LygionOrganization/lygion-wiki/docs/reference/open-lygion/3d3s-chassis.md

# 3D3S 全向底盘

3D3S 全向底盘是一个开源底盘结构项目。目前 Wiki 提供项目 STEP 模型，可用于查看整体结构、评估安装空间并作为后续机械设计的参考。

[下载 STEP 模型](assets/3D3S_Chassis.step){ .md-button }

## 资料

| 文件 | 内容 |
| --- | --- |
| [`3D3S_Chassis.step`](assets/3D3S_Chassis.step) | 3D3S 全向底盘机械结构 STEP 模型 |

## 使用建议

- 先在 CAD 软件中检查模型单位、装配层级和零件干涉。
- 加工或采购零件前，应根据实际硬件复核安装孔、紧固件、线缆空间和运动范围。
- 当前页面不补充未经确认的尺寸、BOM、控制器或负载参数；这些信息应以后续正式发布资料为准。

## 相关入口

- [灵影开源](index.md)
- [下载中心](../../downloads/index.md)
