LygionOrganization/lygion-wiki/docs/reference/index.md

# 产品 Wiki

本章节分别介绍每个产品的具体功能和使用方式。

## 总线设备

| 产品 | 简介 | 推荐入口 |
| --- | --- | --- |
| [RoboCore S3](bus-devices/robocore-s3/index.md) | 用于机器人控制的 ESP32-S3 主控，支持总线设备、网页控制和上位机通信 | [查看文档](bus-devices/robocore-s3/index.md) |
| TTL Adapter (A) | USB / UART 转单线 TTL 总线通信适配器 | [查看文档](bus-devices/ttl-adapter-a/index.md) |
| TTL Encoder E02 | 12bit 360° 绝对角度磁编码器 | [查看文档](bus-devices/ttl-encoder-e02/index.md) |
| TTL Stepper Driver (A) | 单线 TTL 总线步进电机驱动板 | [查看文档](bus-devices/ttl-stepper-driver-a/index.md) |

## Hub 分线板

- [TTL-5264 8P Hub (A)](../reference/bus-devices/hub-boards/ttl-5264-8p-hub-a.md)
- [HC-1.25 8P Hub (A)](../reference/bus-devices/hub-boards/hc-1.25-8p-hub-a.md)

## 建议阅读方式

- 第一次使用：先看 [快速开始](../quickstart/index.md)。
- 遇到基础问题：先看 [基础教程](../tutorials/index.md)。
- 需要产品参数、接线、SDK 和 FAQ：进入对应产品参考页。
