LygionOrganization/lygion-wiki/docs/downloads/index.md

# 下载中心

本页集中放置 Lygion Wiki 中常用的软件、SDK、模型和资料链接。选择对应产品即可下载图片、CAD 模型和示例程序。

## SDK 与软件

| 类型 | GitHub / 官网 | 本站下载 | 相关教程 |
| --- | --- | --- | --- |
| Python SDK | [lygion_devs_py](https://github.com/LygionOrganization/lygion_devs_py) | [lygion_devs_py.zip](../assets/files/lygion_devs_py.zip) | [Python 快速上手](../quickstart/python-first-demo.md) |
| C++ / Arduino SDK | [lygion_devs_cpp](https://github.com/LygionOrganization/lygion_devs_cpp) | [lygion_devs_cpp.zip](../assets/files/lygion_devs_cpp.zip) | [C++ / Arduino 快速上手](../quickstart/cpp-first-demo.md) |
| FD 调试软件 | - | [FD.7z](../assets/files/FD.7z) | [FD 调试软件教程](../tutorials/fd-tool.md) |

## 总线设备模型

| 产品 | CAD / 模型 |
| --- | --- |
| TTL Adapter (A) | [ttl-adapter-a.step](../reference/bus-devices/ttl-adapter-a/assets/ttl-adapter-a.step) |
| TTL Encoder E02 | [TTL-Encoder-E02.step](../reference/bus-devices/ttl-encoder-e02/assets/TTL-Encoder-E02.step) |
| TTL Stepper Driver (A) | [TTL Stepper Driver STEP](../reference/bus-devices/ttl-stepper-driver-a/assets/TTL_SD_Simple%20Assembly.step) |
| Robot Driver with ESP32S3 Lite | [Robot Driver with ESP32S3 Lite.step](<../reference/bus-devices/robot-driver-with-esp32s3-lite/assets/Robot Driver with ESP32S3 Lite.step>) |
| SC-0090-C043 总线舵机 | [SC-0090-C043.step](../reference/bus-devices/bus-servos/assets/SC-0090-C043.step) |
| SC-0090-C049 总线舵机 | [SC-0090-C049.step](../reference/bus-devices/bus-servos/assets/SC-0090-C049.step) |
| SC-1500-C023 总线舵机 | [SC-1500-C023.step](../reference/bus-devices/bus-servos/assets/SC-1500-C023.step) |
| SC-1500-C024 总线舵机 | [SC-1500-C024.stp](../reference/bus-devices/bus-servos/assets/SC-1500-C024.stp) |
| 0090 系列舵盘 | [圆形](../reference/bus-devices/bus-servos/assets/arms-0090/cycle.stp) · [半臂](../reference/bus-devices/bus-servos/assets/arms-0090/haftarm.stp) · [单臂](../reference/bus-devices/bus-servos/assets/arms-0090/onearm.stp) · [十字](../reference/bus-devices/bus-servos/assets/arms-0090/tenarm.stp) |

## 机器人模组模型

| 产品 | CAD / 模型 |
| --- | --- |
| 舵轮 SW69-TTL | [SW69-TTL_STEP.step](../reference/modules/sw69-ttl/assets/SW69-TTL_STEP.step) |
| 步进电机 4240BY-G5.2 | [4240BY-G5.2.step](../reference/modules/4240by-g5-2/assets/4240BY-G5.2.step) |
| 驱动轮 DW69 | [DW69 [SP01].step](<../reference/modules/dw69/assets/DW69 [SP01].step>) · [DW69 [SP02][SP03].step](<../reference/modules/dw69/assets/DW69 [SP02][SP03].step>) |
| 关节执行器 DM42-G7220-E02 | [DW42-G7220-E02.step](../reference/modules/dm42-g7220-e02/assets/DW42-G7220-E02.step) |
| 同步轮 3M 72T | [SP3M72-E02.step](../reference/modules/pulley-3m-72t/assets/SP3M72-E02.step) |

## 开源项目模型

| 项目 | 文件 |
| --- | --- |
| 3D3S 全向底盘 | [3D3S_Chassis.step](../reference/open-lygion/assets/3D3S_Chassis.step) |
| 6x6 Rover | [6x6-rover.zip](../reference/open-lygion/assets/6x6-rover.zip) |
| 5+1 DOF Robotic Arm | [5-plus-1-dof-robotic-arm.step](../reference/open-lygion/assets/5-plus-1-dof-robotic-arm.step) |
| Open Leader Arm | [open_leader_arm.step](../reference/open-lygion/assets/open_leader_arm.step) |
| Self-locking Gripper | [self-locking-gripper.step](../reference/open-lygion/assets/self-locking-gripper.step) |
| OpenLygion 4WD AL | [OpenLygion 4WD AL.step](<../reference/open-lygion/assets/OpenLygion 4WD AL.step>) |
| OpenLygion 4WD SheetMetal | [OpenLygion 4WD SheetMetal.step](<../reference/open-lygion/assets/OpenLygion 4WD SheetMetal.step>) |
| OpenLygion Balance | [OpenLygion Balance.step](<../reference/open-lygion/assets/OpenLygion Balance.step>) |

## 常用入口

- [总线设备](../reference/bus-devices/index.md)
- [机器人整机](../reference/robots/index.md)
- [灵影开源](../reference/open-lygion/index.md)
- [基础教程](../tutorials/index.md)
