LygionOrganization/lygion-wiki/docs/reference/open-lygion/index.md

# 灵影开源

这里收录 Lygion 公开的 SDK、示例工程和机械结构资料。代码以 GitHub 组织内的仓库为准，本站页面主要提供快速入口和本地素材下载。

[LygionOrganization on GitHub](https://github.com/LygionOrganization/){ .md-button }

## SDK

| 页面 | 用途 |
| --- | --- |
| [Python SDK](python-sdk.md) | 在电脑、树莓派、Jetson 等上位机环境中调试和控制 Lygion TTL 总线设备。 |
| [C++ SDK](cpp-sdk.md) | 在 ESP32、Arduino、STM32 Arduino Core、PlatformIO 等嵌入式环境中控制 Lygion TTL 总线设备。 |

## 开源项目

| 项目 | 资料 |
| --- | --- |
| [3D3S 全向底盘](3d3s-chassis.md) | 全向底盘结构项目，提供 STEP 模型。 |
| [6x6 Rover](6x6-rover.md) | 六轮移动底盘，提供项目图片和压缩模型资料。 |
| [5+1 DOF Robotic Arm](5-plus-1-dof-robotic-arm.md) | 5+1 自由度机械臂，提供 STEP 模型。 |
| [Open Leader Arm](open-leader-arm.md) | 开源机械臂结构项目，提供 STEP 模型。 |
| [Self-locking Gripper](self-locking-gripper.md) | 自锁夹爪机构，提供 STEP 模型。 |

!!! tip "第一次使用建议"
    如果你还不熟悉串口、设备 ID、波特率和供电方式，建议先阅读[基础教程](../../tutorials/index.md)，再运行 SDK 示例。
