LygionOrganization/lygion-wiki/docs/reference/open-lygion/open-leader-arm.md

# Open Leader Arm

Open Leader Arm 是一个开源机械臂结构项目。目前 Wiki 提供项目 STEP 模型，可用于查看机械结构、评估安装关系并作为后续设计与装配验证的参考。

[下载 STEP 模型](assets/open_leader_arm.step){ .md-button }

## 资料

| 文件 | 内容 |
| --- | --- |
| [`open_leader_arm.step`](assets/open_leader_arm.step) | Open Leader Arm 机械结构 STEP 模型 |

## 使用建议

- 先在 CAD 软件中确认模型单位、装配层级、关节关系和零件干涉。
- 制作实物前，应根据拟使用的执行器、轴承、紧固件和线缆重新核对安装关系。
- 当前页面不补充未经确认的自由度、行程、负载、BOM 或控制方案；这些信息应以后续正式发布资料为准。

## 相关入口

- [灵影开源](index.md)
- [下载中心](../../downloads/index.md)
