LygionOrganization/lygion-wiki/docs/reference/modules/index.md

# 机器人模组

本分类收录 Lygion 机器人项目中常用的机械、电机、轮组和执行器模组。每个产品页面提供产品概览、典型应用、集成建议和机械资料下载入口。

| 模组 | 简介 | 入口 |
| --- | --- | --- |
| 舵轮 SW69-TTL | 集成转向、行走驱动、编码器反馈和 TTL 总线控制能力的舵轮模组。 | [查看页面](sw69-ttl/index.md) |
| 步进电机 4240BY-G5.2 | 带减速机构的 42 系列双极步进电机，可配合步进驱动器实现位置或速度控制。 | [查看页面](4240by-g5-2/index.md) |
| 同步轮 3M 72T | 72 齿 3M 同步轮，适合机器人关节、转台和同步带传动结构。 | [查看页面](pulley-3m-72t/index.md) |
| 驱动轮 DW69 | 69 mm 级机器人底盘驱动轮组件，适合移动平台和自定义轮式机构。 | [查看页面](dw69/index.md) |
| 关节执行器 DM42-G7220-E02 | 集成步进电机、同步带传动和编码器安装结构的机器人关节执行器。 | [查看页面](dm42-g7220-e02/index.md) |

## 相关分类

- [总线设备](../bus-devices/index.md)
- [机器人整机](../robots/index.md)
