LygionOrganization/lygion-wiki/docs/reference/open-lygion/5-plus-1-dof-robotic-arm.md

# 5+1 DOF Robotic Arm

5+1 DOF Robotic Arm 是一个 5+1 自由度机械臂结构项目。本站目前提供项目 STEP 模型。

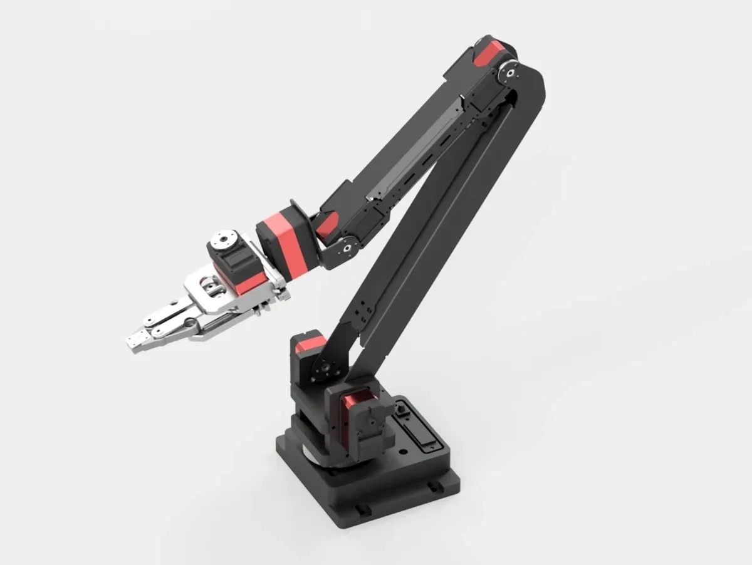
[picture p17: docs/reference/open-lygion/assets/5-plus-1-dof-robotic-arm.webp]
5+1 DOF Robotic Arm


[下载 STEP 模型](assets/5-plus-1-dof-robotic-arm.step){ .md-button }

## 资料

| 文件 | 说明 |
| --- | --- |
| [`5-plus-1-dof-robotic-arm.step`](assets/5-plus-1-dof-robotic-arm.step) | 机械结构 STEP 模型 |

## 使用建议

- STEP 文件可用于结构查看、装配参考和二次设计。
- 上电调试前，请先确认各关节零位、运动范围和线缆余量。
- 控制程序可参考 [Python SDK](python-sdk.md) 或 [C++ SDK](cpp-sdk.md)。
