LygionOrganization/lygion-wiki/docs/en/reference/open-lygion/index.md

# Open Lygion

This section collects public Lygion SDKs, example projects, and mechanical resources. Source code should be treated as authoritative on GitHub; the Wiki provides quick entry points and local downloads for commonly used assets.

[LygionOrganization on GitHub](https://github.com/LygionOrganization/){ .md-button }

## SDKs

| Page | Use case |
| --- | --- |
| [Python SDK](python-sdk.md) | Develop and debug Lygion TTL bus devices from PCs, Raspberry Pi, Jetson, and other host platforms. |
| [C++ SDK](cpp-sdk.md) | Control Lygion TTL bus devices from ESP32, Arduino, STM32 Arduino Core, PlatformIO, and similar embedded environments. |

## Open Projects

| Project | Resource |
| --- | --- |
| [3D3S Omnidirectional Chassis](3d3s-chassis.md) | Omnidirectional chassis structure with a downloadable STEP model. |
| [6x6 Rover](6x6-rover.md) | Six-wheel mobile platform with downloadable model package. |
| [5+1 DOF Robotic Arm](5-plus-1-dof-robotic-arm.md) | 5+1 DOF robotic arm structure with STEP model. |
| [Open Leader Arm](open-leader-arm.md) | Open robotic-arm structure with a downloadable STEP model. |
| [Self-locking Gripper](self-locking-gripper.md) | Self-locking end-effector mechanism with STEP model. |

!!! tip "Start with the fundamentals"
    If serial ports, device IDs, baud rates, and power wiring are new to you, read the [tutorials](../../tutorials/index.md) before running SDK examples.
