LygionOrganization/lygion-wiki/docs/en/reference/modules/index.md

# Robot Modules

This section covers Lygion mechanical modules, drive modules, and joint modules that are commonly used in mobile robots, teaching platforms, and experimental mechanisms.

| Module | What it is for | Page |
| --- | --- | --- |
| SW69-TTL Steering Wheel Module | A compact steering-and-drive wheel module for omnidirectional mobile robot bases. | [Open page](sw69-ttl/index.md) |
| 4240BY-G5.2 Stepper Motor | A geared 42 mm stepper motor for low-speed, higher-torque robot mechanisms. | [Open page](4240by-g5-2/index.md) |
| DW69 Drive Wheel | A 69 mm drive wheel assembly for small mobile robot chassis. | [Open page](dw69/index.md) |
| DM42-G7220-E02 Joint Actuator | A belt-driven stepper joint with output-side encoder feedback. | [Open page](dm42-g7220-e02/index.md) |
| 3M 72T Timing Pulley | A 72-tooth 3M timing pulley for belt-driven joints and rotary mechanisms. | [Open page](pulley-3m-72t/index.md) |

## Related Documentation

- [TTL Bus Devices](../bus-devices/index.md)
- [Downloads](../../downloads/index.md)
- [Quick Start](../../quickstart/index.md)
