LygionOrganization/lygion-wiki/docs/reference/modules/pulley-3m-72t/index.md

# 同步轮 3M 72T

同步轮 3M 72T 是一款用于 3M 齿形同步带传动的 72 齿同步轮。该产品适合用于机器人关节、转台、轮组、滑台和其它需要同步带传动的机械结构。

## 产品特点

- 3M 齿形规格，适配 3M 同步带。
- 72 齿设计，适合构建较大直径输出端或减速传动结构。
- 提供 E02 编码器安装相关结构，适合需要角度反馈的输出轴应用。
- 提供 PDF、DXF 和 STEP 资料，便于结构设计和加工核对。

## 典型应用

- 机器人关节输出端同步轮
- 转台或摆臂机构
- 同步带减速结构
- 需要在输出端读取角度的传动机构

## 机械接口

下表列出当前图纸中可快速识别的主要机械信息。正式设计时请以 PDF、DXF 或 STEP 文件为准。

| 项目 | 参数 |
| --- | --- |
| 同步带规格 | 3M |
| 齿数 | 72T |
| 编码器安装孔 | 8 × M3 × 0.5 |
| 编码器安装孔分布圆 | Ø60 |
| 辅助安装孔 | 6 × M4 × 0.7 通孔 |
| 中心参考孔径 | Ø23 |

!!! note "图纸优先"
    同步轮会直接影响同步带啮合、中心距和输出端同轴度。设计中心距、皮带长度和安装孔位时，请以机械图纸和 3D 模型为准。

## 与编码器配合

若需要读取同步轮或输出轴角度，可将同步轮结构与 [TTL Encoder E02](../../bus-devices/ttl-encoder-e02/index.md) 配合使用。编码器通过检测磁铁角度输出绝对位置，适用于关节角度读取、输出端校准和上电位置恢复等场景。

使用编码器时需要注意：

- 磁铁中心应尽量对准编码器 IC 中心。
- 磁铁与编码器 IC 上表面的距离应符合编码器安装要求。
- 编码器 PCB 应固定可靠，避免运行时松动。
- 编码器 ID 应与同一 TTL 总线上的其它设备保持唯一。

## 设计建议

1. 根据同步带规格、齿数和中心距计算合适的皮带长度。
2. 输出端负载较大时，应检查同步带张力、轴承支撑和安装板刚性。
3. 若作为关节输出端，应预留编码器线缆和维护空间。
4. 加工前请使用 STEP 模型检查同步轮、轴承、支架和相邻零件之间的干涉。

## 资料下载

| 资料 | 文件 |
| --- | --- |
| STEP 3D 模型 | [SP3M72-E02.step](assets/SP3M72-E02.step) |
| 机械图纸 PDF | [SP3M72-E02.pdf](assets/SP3M72-E02.pdf) |
| DXF 图纸 | [SP3M72-E02.dxf](assets/SP3M72-E02.dxf) |

## 相关资料

- [TTL Encoder E02](../../bus-devices/ttl-encoder-e02/index.md)
- [TTL Encoder E02：硬件安装](../../bus-devices/ttl-encoder-e02/hardware-installation.md)
- [机器人模组](../index.md)
