LygionOrganization/lygion-wiki/docs/en/reference/open-lygion/6x6-rover.md

# 6x6 Rover

6x6 Rover is an open six-wheel mobile platform project. The current Wiki page provides the project image and downloadable model package. The model package can be used as the starting point for 3D-printed builds or mechanical review.

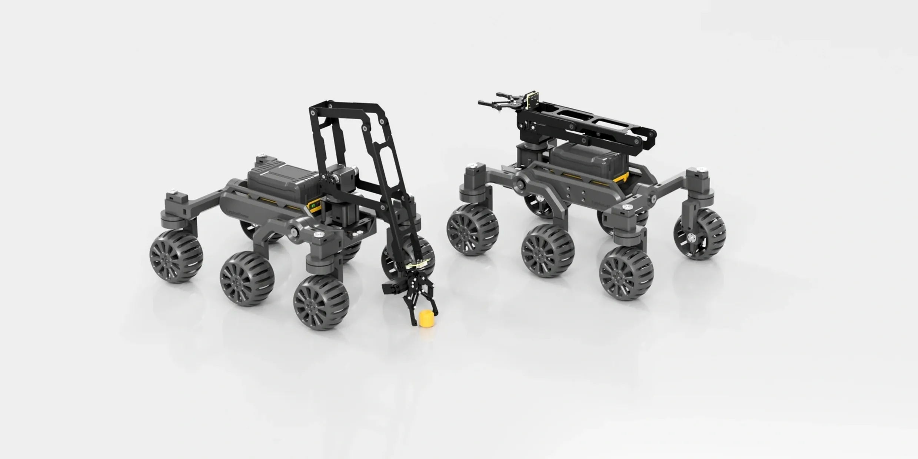
[picture p70: docs/reference/open-lygion/assets/6x6-rover.webp]
6x6 Rover


[Download Model Package](../../../reference/open-lygion/assets/6x6-rover.zip){ .md-button }

## Resources

| File | Description |
| --- | --- |
| [`6x6-rover.zip`](../../../reference/open-lygion/assets/6x6-rover.zip) | Mechanical model / project resource package |

## Notes

- Extract the ZIP package before opening the model files.
- Before redesigning the platform, check the space needed for the battery, controller, servos, motors, and wiring.
- For control software, see the [Python SDK](python-sdk.md), [C++ SDK](cpp-sdk.md), and [TTL bus tutorials](../../tutorials/index.md).
