LygionOrganization/lygion-wiki/docs/en/reference/bus-devices/bus-servos/sc-1500-c023.md

# SC-1500-C023 Dual-Shaft TTL Bus Servo

SC-1500-C023 is a 15kg.cm class dual-shaft TTL serial bus servo. Its specification model is `SCS15-C023`. It uses a plastic housing, cored motor, brass gears, and ball bearings, making it suitable for medium-load joints, dual-supported linkages, mobile robot mechanisms, and educational platforms.

SC-1500-C023

[Download 3D Model](../../../../reference/bus-devices/bus-servos/assets/SC-1500-C023.step){ .md-button download }

## Key Specifications

| Item | Value |
| --- | --- |
| Specification model | `SCS15-C023` |
| Output structure | Dual shaft |
| Operating voltage | DC 9-12.6V |
| Recommended supply | 3S lithium battery pack or DC supply up to 12.6V |
| No-load speed | 0.167sec/60deg, about 60RPM |
| No-load current | 240mA |
| Stall torque | 15.6kg.cm |
| Stall current | 2.5A |
| Static current | 40mA |
| Rated load | 5kg.cm, about 1/3 of stall torque |
| Rated current | 800mA |
| Kt constant | 6.5kg.cm/A |
| Operating temperature | -10 to 60degC |
| Storage temperature | -30 to 80degC |

## Mechanical Data

| Item | Value |
| --- | --- |
| Dimensions | 40.2 x 20.2 x 40mm |
| Weight | 58.2 +/- 1g |
| Housing | PA |
| Gears | Brass |
| Bearing | Ball bearing |
| Angle sensor | Carbon-film potentiometer |
| Connector | PH2.0-3P |
| Cable length | 15cm |
| Output spline | 25T / OD 5.9mm |
| Gear ratio | 1/275 |
| Backlash | <=0.5deg |
| Output screw | M3 x 6 |
| Motor | Cored motor |

## 3D Model

- [Servo body STEP](../../../../reference/bus-devices/bus-servos/assets/SC-1500-C023.step){ download }

## Connector and Pinout

| Pin | Definition |
| --- | --- |
| 1 | GND |
| 2 | Vcc |
| 3 | Signal / TTL |

!!! warning "Check the connector before wiring"
    This model uses a PH2.0-3P connector. Follow the pinout for this model and do not mix it with other connector families.

## Control Characteristics

| Item | Value |
| --- | --- |
| Control signal | Digital packet |
| Protocol | Half-duplex asynchronous serial, 8 data bits, 1 stop bit, no parity |
| ID range | 0-253, factory default ID 1 |
| Baud rate | 38400bps-500000bps, factory default 500000bps |
| Control algorithm | PID, configurable |
| Center position | 511 |
| Controllable angle | 210 +/- 5deg, position range 0-1023 |
| Electronic resolution | 0.215deg/pulse, 220deg/1024 |
| Default direction | Clockwise, 0 to 1023, configurable |
| Feedback | Load, position, operating speed, input voltage, temperature |
| Operating modes | Mode 0: position servo mode; Mode 2: open-loop speed motor mode |

## Motion Characteristics

SC-1500-C023 Motion Characteristics

## Protection and Reliability

- Overload protection: triggers after load exceeds 80% of stall torque for 4s. Send a new position command to clear the overload flag.
- Over-voltage / under-voltage protection: triggers above 12.6V or below 9V, and clears automatically once voltage returns to range.
- Over-temperature protection: disables torque output above 70degC.
- Maximum position update rate: 1ms.
- Logic high: 2-5V.
- Logic low: 0-0.45V.
- Load life test: more than 50,000 cycles.
- Waterproofing: not waterproof.

## Getting Started

- [Power and Wiring](../../../tutorials/power-and-wiring-basics.md)
- [Power Grouping and Isolation](../../../tutorials/power-grouping-and-decoupling.md)
- [Device IDs and Baud Rates](../../../tutorials/device-id-and-baudrate.md)
- [FD Device Utility](../../../tutorials/fd-tool.md)
- [Find the Serial Port](../../../tutorials/find-serial-port.md)
- [Communication Troubleshooting](../../../tutorials/communication-troubleshooting.md)

!!! danger "Plan for peak current"
    A 15kg.cm class servo can draw high peak current during startup or stall. Size the power supply, switch, wiring, and hub for peak current, not only average load.
