LygionOrganization/lygion-wiki/docs/en/reference/bus-devices/hub-boards/hc-1.25-8p-hub-a.md

# HC-1.25 8P Hub (A)

HC-1.25 8P Hub (A) fans out one TTL bus into eight compact HC-1.25-3P connectors. It is intended for small robots, dexterous hands, legged robots, and other space-constrained modular systems.

[Power grouping and isolation guide](../../../tutorials/power-grouping-and-decoupling.md){ .md-button }

## Features

- Eight HC-1.25-3P device connectors
- HX-5264-3P connection for TTL Adapter (A) or a compatible controller
- GH-1.25-3P communication-only connection for cascading or power isolation
- Power indicator
- Approximate size: `39 x 21 mm`
- Four mounting holes, approximately 2.6 mm diameter

## Interfaces

| No. | Interface | Purpose |
| --- | --- | --- |
| 1 | HX-5264-3P | Communication and power connection to TTL Adapter (A) or a compatible controller |
| 2 | Eight HC-1.25-3P connectors | Connect compact TTL bus devices |
| 3 | Power indicator | Shows whether power is present |
| 4 | GH-1.25-3P | Communication-only connection to an adapter or another hub |
| 5 | Mounting holes | Four holes, approximately 2.6 mm diameter |

!!! warning "GH-1.25-3P is for communication only"
    Power devices through a connector or input explicitly designed to carry power.
