LygionOrganization/lygion-wiki/docs/reference/bus-devices/robocore-s3/json-api.md

# RoboCore S3 JSON 接口

RoboCore S3 完整固件使用人类可读的 JSON 指令控制设备。下文按用途列出指令、参数与发送示例。

## 通信方式

- **WebSocket**：`ws://192.168.4.1/ws`，每帧发送一个完整 JSON 文本；执行结果广播到已连接客户端。
- **HTTP**：`POST /api/cmd`，`Content-Type: application/json`。返回 `202 {"accepted":true,"policy":"latest-wins"}` 仅表示已接收；使用 `GET /api/result` 读取最新执行结果，按 `rid` 匹配。不是同步执行接口，不会返回历史结果。
- **USB CDC**：原生 USB 端口，每条 UTF-8 JSON 后发送 `\n`。持续读取换行分隔的回复；日志与 JSON 可能混合，忽略非 JSON 行。默认启用 USB 输出；若 `T=604` 关闭了 USB 输出，就无法从该端口读取结果。
- **ESP-NOW**：沿用原有 250 字节、零填充 JSON 消息帧，接收模式、可信 MAC 与信道按 `T=410…414` 配置。该传输不自动返回执行结果。

命令最大 255 字节（UTF-8 编码，不计换行）。HTTP/WebSocket 使用单个完整请求体/文本帧；分片或超长数据拒绝。JSON 必须有整数 `T`。可加入 `rid`（0…4294967295 整数）；执行结果原样返回，客户端同时最多等待一条命令，建议随机起始并递增，避免多客户端碰撞。

**最新命令优先**：当前命令不被抢占，仅保留最新的一条待执行指令。运行 1 时收到 2、3，之后执行 3。HTTP、WebSocket、USB、ESP-NOW 等共用这一队列。不保证每条指令执行，也不自动重试 EEPROM 写入。配置流程应逐条发出并等待对应结果，超时先读取状态再决定是否重试。

`{"T":0}` 在接收时设置退出循环标志、清空待执行命令，不入队，也没有结构化的执行回复。它会在循环检查点生效，不等于电机急停。连续速度用 `T=725,speed=0` 停止，关闭步进输出用 `T=726,enable=0`。永久任务占住执行器时，普通指令等待；先停止任务再执行调试命令。

自动化脚本的编辑、保存和运行见 [网页自动化脚本](automation.md)。

## 通用参数与使用顺序

JSON 的字段名区分大小写。表格中的示例是完整对象；按实际设备修改 ID、位置和速度后再发送。除明确标为可选的参数外，请填写示例中的全部字段。舵机与机械臂指令的参数范围因型号和机构而异，发送前应核对目标设备及机械行程。同步接口会校验数组长度、ID唯一性、位置范围与数值类型；SCS位置0–1023，其他同步位置0–4095。

| 字段 | 含义与单位 |
| --- | --- |
| `id` / `old_id` / `new_id` | 当前、原、新设备 ID。普通控制使用实际单个 ID；254 为部分旧协议的广播地址，读取/改 ID 不使用广播 |
| `baud` | 主控 UART 总线比特率，必须与设备一致；推荐优先使用 T=10，重启后按启动配置恢复 |
| `pos` | 舵机位置计数；SCS 常见范围 0–1023，STS/SMS/HLS 常见 0–4095，最终以具体型号及限位为准 |
| `spd` / `acc` | 舵机速度/加速度寄存器值。不是所有型号都接受 0，0 也不一定表示停止；HLS 使用非零速度 |
| `time` | SCS 运动时间，毫秒；与速度的优先关系按舵机协议。不要用 time=0、spd=0 作为停止命令 |
| `state` | 舵机扭矩：0 释放，1 使能；释放前支撑负载 |
| `cl` / `tor` | HLS 单轴电流限制 / 同步控制中每轴限制数组，寄存器值，不直接表示安培 |
| `idn` | 同步控制的设备数；所有数组长度均应等于 idn，范围1–16，不能超过连接设备数量；完整命令也必须能装入255字节 |
| `id[] / pos[] / spd[] / acc[] / tor[]` | 同索引属于同一轴。简化同步命令省略速度/加速度字段，并不提供与完整同步命令相同的控制选项 |
| `mid` / `ang` / `rad` | SCS 角度控制的参考计数 / 目标角度（度）/ 目标弧度，依赖 T=102 的换算设置；这两种指令的 spd 分别为度/秒、弧度/秒 |
| `move` | T=109/112/115：1 立即下发运动，0 预置寄存器动作，再用 T=118 触发 |
| `steps` / `angle` | T=102：每圈计数至少512、行程角度90–360°，用于舵机坐标换算 |
| `set` | T=200 为 `[灯序号,r,g,b]`，T=201 为 `[r,g,b]`；针对兼容旧灯控制器，不是 T=712 的色值规范 |
| `line` / `text` / `update` | OLED 行号1–4、ASCII文本、是否刷新（0暂存/1刷新）；T=203 刷新，T=204 的 l1…l4 一起更新 |
| `num` | 旧 Node 接口的灯数量/刷新范围，按对应设备协议；Node 控制优先 T=712 |
| `freq` / `duration` | 蜂鸣器频率Hz、持续毫秒；duration=0 不表示持续鸣叫 |
| `ang[] / rad[] / pos[]` | 机械臂四关节角度、弧度、零位计数数组；顺序为底座、肩、肘、夹爪 |
| `xyzg` | 机械臂 `[x,y,z,g]`，位置为mm、夹爪角度为度；工作空间取决于匹配的机械臂结构 |
| `rbzg` | 机械臂 `[r,b,z,g]`，r/z为mm、底座角b和夹爪角g为度 |
| `spd` / `br`（机械臂） | 平滑运动参数、底座插值比例；不是舵机原始 spd 单位，请使用匹配机械臂的配置 |
| `flag` / `hz` | T=145：周期反馈开关0/1、反馈频率；不会替换 T=740 的板载惯性传感器读取 |
| `flag` / `axis` / `delta` | T=146：连续运动开关0/1、预设坐标轴、每次增量；仅适用于匹配的机械臂应用 |

先用 T=700 扫描，再用对应反馈指令读取设备，最后测试低速、限位内的动作。同一组 IO4/IO5 的 TTL 与总线设备 RS485 共用波特率和数据，不能当作独立串口。外部 CAN/RS485 在 IO13/IO14，由开关与运行程序共同决定通信功能。

### 同步舵机示例

两只 STS/SMS 舵机应有不同 ID，并支持目标位置。先分别读取 T=15，再发送：

```json
{"T":16,"id":[1,2],"idn":2,"pos":[2047,2100],"spd":[100,100],"acc":[10,10]}
```

若只是要读取板子本身的运动数据，使用 `{"T":740}`；它读取板载 QMI8658A，不是外接 TTL IMU。

## 发送与接收示例

以下接收内容是示意，实际 ID 和读数以设备为准。HTTP 使用 GET /api/result 获取接收结果；WebSocket 直接接收推送。

| 操作 | 发送 | 接收示例 |
| --- | --- | --- |
| 扫描设备 | `{"T":700,"first":0,"last":20,"rid":1}` | `{"T":700,"rid":1,"ok":true,"ids":[1,5],"first":0,"last":20}` |
| 读取编码器 | `{"T":732,"id":1,"rid":2}` | `{"T":732,"rid":2,"id":1,"ok":true,"bus_error":0,"reply_status":0,"pos":2048,"speed":0}` |
| IMU 不可用 | `{"T":740,"rid":3}` | `{"T":740,"rid":3,"ok":false,"present":false,"error":"imu_not_present"}` |

`ok:false` 表示参数或设备通信失败。部分指令返回 `dispatched:true`，只表示处理器已完成分发，不代表电机动作成功。设备 ID 设置 T=13/23/33/710/720 会检查新 ID；编码器与步进驱动共用 T=720。

## 只读端点

| 端点 | 内容 |
| --- | --- |
| GET /api/info | 固件、总线波特率、IMU、任务状态，以及 sta_state、sta_ip、ap_ip、sta_ssid；无密码 |
| GET /api/result | 最新一条执行结果，通过 rid 匹配；不保存历史 |
| GET /api/imu | 板载 IMU 最新有效快照；只读，不进入指令队列，字段见下文 |

## IMU 反馈（T=740 / GET /api/imu）

`GET /api/imu` 直接返回只读快照，不进入指令队列。单次指令发送 `{"T":740,"rid":1}`，成功接收格式如下（数值仅为示例）：

```json
{"T":740,"rid":1,"ok":true,"present":true,"address":106,"sample_age_ms":2,"sample_count":123,"temperature_c":25.0,"accel_g":[0,0,1],"gyro_dps":[0,0,0]}
```

| 字段 | 含义 |
| --- | --- |
| `present` / `address` | 是否检测到传感器 / 十进制 I2C 地址 |
| `accel_g` / `gyro_dps` | X、Y、Z 轴加速度（g）/ 角速度（度/秒）|
| `temperature_c` | 传感器温度（℃）|
| `sample_count` | 24 位循环样本计数；相同计数表示同一份样本 |
| `sample_age_ms` | 缓存样本距今的毫秒数；无有效样本为 -1 |
| `ok` / `error` | 仅在 ok=true 时使用测量值；超过 100 ms 的旧样本返回 imu_no_fresh_sample |

实时读取应逐次等待响应，建议每秒约 10 次或更低，不保存请求历史。网页估算横滚、俯仰和相对航向；六轴 IMU 不提供绝对航向。

T=723/732 的 reply_status 表示位置和速度读取回复中的合并状态标志。T=723 的 device_status 来自实际驱动状态寄存器，device_fault、current_limited、limit_active、target_out_of_range 分别表示故障、限流、限位和目标越界；限流不等于故障。

<!-- COMMAND_TABLES -->

## 通信与系统

| T | 功能 | 发送 JSON | 参数说明 |
| --- | --- | --- | --- |
| 0 | 停止任务循环 | `{"T":0}` | 请求退出任务循环、清空待执行指令；不会关闭电机输出。 |
| 51 | 等待毫秒数 | `{"T":51,"delay":1000}` | delay：等待时间，毫秒；任务中使用可控制步骤节奏。 |
| 180 | 四路轮毂电机速度 | `{"T":180,"A":0,"B":0,"C":0,"D":0}` | A/B/C/D 为匹配的四路轮毂电机速度，寄存器值 × 0.06 = rpm；不是通用步进控制。 |
| 399 | 清空文件系统 | `{"T":399}` | 清空全部任务及文件系统内配置；不自动重启，无法撤销。 |
| 400 | 设置 Wi-Fi | `{"T":400,"mode":1,"ap_ssid":"LYgion","ap_password":"12345678","channel":1,"sta_ssid":"ssid","sta_password":"password"}` | mode=0 关闭 Wi-Fi，1 开启 AP+STA。STA 后台连接，失败仍保留配置；GET /api/info 查询状态和 IP。路由器须支持 2.4 GHz。 |
| 401 | 读取 Wi-Fi 配置 | `{"T":401}` | 按示例字段设置参数；执行前确认目标设备和供电。 |
| 402 | 读取热点 IP | `{"T":402}` | 按示例字段设置参数；执行前确认目标设备和供电。 |
| 403 | 读取路由器分配的 IP | `{"T":403}` | 按示例字段设置参数；执行前确认目标设备和供电。 |
| 410 | 初始化 ESP-NOW | `{"T":410,"longrange":0}` | longrange：0 普通模式，1 长距离模式；双方需支持并使用兼容模式、同一信道。 |
| 411 | 设置 ESP-NOW 接收模式 | `{"T":411,"mode":1}` | mode：0 关闭接收，1 接收可信 MAC，2 接收广播。 |
| 412 | 读取 MAC 地址 | `{"T":412}` | 按示例字段设置参数；执行前确认目标设备和供电。 |
| 413 | 发送 ESP-NOW JSON | `{"T":413,"mac":"FF:FF:FF:FF:FF:FF","data":"{\"T\":205}"}` | mac 为冒号分隔的 MAC；data 为转义的 JSON 字符串。使用 250 字节补零帧，不能任意发送大对象。 |
| 414 | 添加 ESP-NOW 对端 | `{"T":414,"mac":"FF:FF:FF:FF:FF:FF"}` | mac 为对端 MAC 地址；先确认双方 Wi-Fi 信道相同。 |
| 415 | ESP-NOW 模拟 MAC 开关 | `{"T":415,"fake":0}` | fake 为兼容应用的模拟 MAC 开关；常规通信保持 0。 |
| 501 | 发送 CAN 帧 | `{"T":501,"id":291,"ext":0,"data":[17,34,51]}` | CAN 档；id 为标识符，ext=0 标准帧/1 扩展帧，data 最多 8 个 0–255 字节；默认 500 kbps。 |
| 600 | 重启主控 | `{"T":600}` | 立即重启，连接中断；可能无法收到执行回复。 |
| 601 | 清空 NVS | `{"T":601}` | 清空 NVS 设置；与任务文件系统不同。此操作不可撤销。 |
| 602 | 清空文件系统 | `{"T":602}` | 清空全部任务及文件系统内配置；不自动重启，无法撤销。 |
| 603 | 读取消息输出设置 | `{"T":603}` | 按示例字段设置参数；执行前确认目标设备和供电。 |
| 604 | 设置消息输出 | `{"T":604,"echo":1,"uart":0,"usb":1}` | echo/uart/usb 为 0 或 1；关闭 usb 后 USB 不再输出结果。 |
| 605 | UART0 转发模式 | `{"T":605,"sf":1}` | sf=1 转发 UART0 字节到舵机总线（默认）；sf=0 将 UART0 输入按 JSON 解析。 |

## 舵机

| T | 功能 | 发送 JSON | 参数说明 |
| --- | --- | --- | --- |
| 10 | 设置主控总线波特率 | `{"T":10,"baud":1000000}` | 按示例字段设置参数；执行前确认目标设备和供电。 |
| 11 | STS/SMS 位置控制 | `{"T":11,"id":1,"pos":2047,"spd":100,"acc":0}` | 按示例字段设置参数；执行前确认目标设备和供电。 |
| 12 | STS/SMS 设置中位 | `{"T":12,"id":1}` | 按示例字段设置参数；执行前确认目标设备和供电。 |
| 13 | STS/SMS 修改 ID | `{"T":13,"old_id":1,"new_id":2}` | old_id / new_id 为不同的 0–253 整数。逐个接入设备，拒绝已占用的新 ID，并在写入后验证新 ID。 |
| 14 | STS/SMS 扭矩开关 | `{"T":14,"id":1,"state":1}` | 按示例字段设置参数；执行前确认目标设备和供电。 |
| 15 | STS/SMS 状态反馈 | `{"T":15,"id":1}` | 按示例字段设置参数；执行前确认目标设备和供电。 |
| 16 | STS/SMS 同步控制 | `{"T":16,"id":[1,2],"idn":2,"pos":[2047,2047],"spd":[100,100],"acc":[0,0]}` | 按示例字段设置参数；执行前确认目标设备和供电。 |
| 17 | STS/SMS 简化同步控制 | `{"T":17,"id":[1,2],"idn":2,"pos":[2047,2047]}` | 速度与加速度固定为0，0的含义按舵机型号；需要限速时用T=16。 |
| 21 | HLS 位置控制 | `{"T":21,"id":1,"pos":2047,"spd":100,"acc":0,"cl":500}` | 按示例字段设置参数；执行前确认目标设备和供电。 |
| 22 | HLS 设置中位 | `{"T":22,"id":1}` | 按示例字段设置参数；执行前确认目标设备和供电。 |
| 23 | HLS 修改 ID | `{"T":23,"old_id":1,"new_id":2}` | old_id / new_id 为不同的 0–253 整数。逐个接入设备，拒绝已占用的新 ID，并在写入后验证新 ID。 |
| 24 | HLS 扭矩开关 | `{"T":24,"id":1,"state":1}` | 按示例字段设置参数；执行前确认目标设备和供电。 |
| 25 | HLS 状态反馈 | `{"T":25,"id":1}` | 按示例字段设置参数；执行前确认目标设备和供电。 |
| 26 | HLS 同步控制 | `{"T":26,"id":[1,2],"idn":2,"pos":[2047,2047],"spd":[100,100],"acc":[0,0],"tor":[500,500]}` | 按示例字段设置参数；执行前确认目标设备和供电。 |
| 27 | HLS 简化同步控制 | `{"T":27,"id":[1,2],"idn":2,"pos":[2047,2047],"tor":[500,500]}` | 固定速度60、加速度50；tor 数组指定各轴电流限制。需要完整参数时用T=26。 |
| 31 | SCS 位置控制 | `{"T":31,"id":1,"pos":511,"time":0,"spd":100}` | 按示例字段设置参数；执行前确认目标设备和供电。 |
| 33 | SCS 修改 ID | `{"T":33,"old_id":1,"new_id":2}` | old_id / new_id 为不同的 0–253 整数。逐个接入设备，拒绝已占用的新 ID，并在写入后验证新 ID。 |
| 34 | SCS 扭矩开关 | `{"T":34,"id":1,"state":1}` | 按示例字段设置参数；执行前确认目标设备和供电。 |
| 35 | SCS 状态反馈 | `{"T":35,"id":1}` | 按示例字段设置参数；执行前确认目标设备和供电。 |
| 36 | SCS 同步控制 | `{"T":36,"id":[1,2],"idn":2,"pos":[511,511],"spd":[100,100]}` | 按示例字段设置参数；执行前确认目标设备和供电。 |
| 37 | SCS 简化同步控制 | `{"T":37,"id":[1,2],"idn":2,"pos":[511,511]}` | 速度固定为0，可能代表最高速度；需要限速时用T=36。 |
| 100 | 设置主控总线波特率 | `{"T":100,"baud":1000000}` | 按示例字段设置参数；执行前确认目标设备和供电。 |
| 101 | 选择通用舵机类型 | `{"T":101,"type":1}` | type=0 SCS、1 STS/SMS、2 HLS；优先使用明确区分型号的指令。 |
| 102 | 设置舵机坐标换算 | `{"T":102,"steps":4096,"angle":360}` | steps 为舵机每圈计数，angle 为行程角度；这是舵机坐标换算，与外接编码器无关。 |
| 103 | 通用舵机反馈 | `{"T":103,"id":1}` | 按示例字段设置参数；执行前确认目标设备和供电。 |
| 104 | 通用舵机 Ping | `{"T":104,"id":1}` | 按示例字段设置参数；执行前确认目标设备和供电。 |
| 105 | 通用舵机修改 ID | `{"T":105,"old_id":1,"new_id":2}` | 按示例字段设置参数；执行前确认目标设备和供电。 |
| 106 | 通用舵机设置中位 | `{"T":106,"id":1}` | 按示例字段设置参数；执行前确认目标设备和供电。 |
| 107 | 通用舵机移动至中位 | `{"T":107,"id":1}` | 按示例字段设置参数；执行前确认目标设备和供电。 |
| 108 | 通用舵机扭矩开关 | `{"T":108,"id":1,"state":1}` | 按示例字段设置参数；执行前确认目标设备和供电。 |
| 109 | SCS 步数控制 | `{"T":109,"id":1,"pos":512,"time":0,"spd":100,"move":1}` | 按示例字段设置参数；执行前确认目标设备和供电。 |
| 112 | SCS 角度控制 | `{"T":112,"id":1,"mid":512,"ang":10,"spd":10,"move":1}` | 按示例字段设置参数；执行前确认目标设备和供电。 |
| 115 | SCS 弧度控制 | `{"T":115,"id":1,"mid":512,"rad":0.785,"spd":0.2,"move":1}` | 按示例字段设置参数；执行前确认目标设备和供电。 |
| 118 | 执行预置舵机动作 | `{"T":118}` | 按示例字段设置参数；执行前确认目标设备和供电。 |
| 119 | SCS 扭矩限制 | `{"T":119,"id":1,"limit":500}` | 兼容高级接口；请使用对应型号驱动库配置扭矩限制。 |

## 机械臂预设

| T | 功能 | 发送 JSON | 参数说明 |
| --- | --- | --- | --- |
| 130 | 读取机械臂零位 | `{"T":130}` | 仅用于匹配固件几何参数、舵机 ID 和零位的机械臂；不是任意机械臂通用接口。数组顺序为四个关节/坐标分量。 |
| 131 | 设置机械臂零位 | `{"T":131,"pos":[512,512,512,512]}` | 仅用于匹配固件几何参数、舵机 ID 和零位的机械臂；不是任意机械臂通用接口。数组顺序为四个关节/坐标分量。 |
| 132 | 读取机械臂位置 | `{"T":132}` | 仅用于匹配固件几何参数、舵机 ID 和零位的机械臂；不是任意机械臂通用接口。数组顺序为四个关节/坐标分量。 |
| 133 | 以当前位置标定机械臂零位 | `{"T":133}` | 仅用于匹配固件几何参数、舵机 ID 和零位的机械臂；不是任意机械臂通用接口。数组顺序为四个关节/坐标分量。 |
| 134 | 机械臂关节角度 | `{"T":134,"ang":[0,0,0,0]}` | 仅用于匹配固件几何参数、舵机 ID 和零位的机械臂；不是任意机械臂通用接口。数组顺序为四个关节/坐标分量。 |
| 135 | 机械臂关节弧度 | `{"T":135,"rad":[0,0,0,0]}` | 仅用于匹配固件几何参数、舵机 ID 和零位的机械臂；不是任意机械臂通用接口。数组顺序为四个关节/坐标分量。 |
| 136 | 机械臂 XYZG 目标 | `{"T":136,"xyzg":[260.5,0,122.38,50]}` | 仅用于匹配固件几何参数、舵机 ID 和零位的机械臂；不是任意机械臂通用接口。数组顺序为四个关节/坐标分量。 |
| 137 | 机械臂 RBZG 目标 | `{"T":137,"rbzg":[260.5,0,122.38,50]}` | 仅用于匹配固件几何参数、舵机 ID 和零位的机械臂；不是任意机械臂通用接口。数组顺序为四个关节/坐标分量。 |
| 138 | 机械臂平滑 XYZG 运动 | `{"T":138,"xyzg":[236.5,0,122.38,0],"spd":0.4}` | 仅用于匹配固件几何参数、舵机 ID 和零位的机械臂；不是任意机械臂通用接口。数组顺序为四个关节/坐标分量。 |
| 139 | 机械臂平滑 RBZG 运动 | `{"T":139,"rbzg":[236.5,0,122.38,0],"spd":0.4,"br":200}` | 仅用于匹配固件几何参数、舵机 ID 和零位的机械臂；不是任意机械臂通用接口。数组顺序为四个关节/坐标分量。 |
| 140 | 机械臂最大关节速度 | `{"T":140,"spd":1.2}` | 仅用于匹配固件几何参数、舵机 ID 和零位的机械臂；不是任意机械臂通用接口。数组顺序为四个关节/坐标分量。 |
| 141 | 读取机械臂反馈弧度 | `{"T":141}` | 仅用于匹配固件几何参数、舵机 ID 和零位的机械臂；不是任意机械臂通用接口。数组顺序为四个关节/坐标分量。 |
| 142 | 读取机械臂目标弧度 | `{"T":142}` | 仅用于匹配固件几何参数、舵机 ID 和零位的机械臂；不是任意机械臂通用接口。数组顺序为四个关节/坐标分量。 |
| 143 | 读取 XYZG 解算状态 | `{"T":143}` | 仅用于匹配固件几何参数、舵机 ID 和零位的机械臂；不是任意机械臂通用接口。数组顺序为四个关节/坐标分量。 |
| 144 | 读取 RBZG 解算状态 | `{"T":144}` | 仅用于匹配固件几何参数、舵机 ID 和零位的机械臂；不是任意机械臂通用接口。数组顺序为四个关节/坐标分量。 |
| 145 | 机械臂周期反馈 | `{"T":145,"flag":0,"hz":10}` | 仅用于匹配固件几何参数、舵机 ID 和零位的机械臂；不是任意机械臂通用接口。数组顺序为四个关节/坐标分量。 |
| 146 | 机械臂连续运动 | `{"T":146,"flag":0,"axis":0,"delta":0.01}` | 仅用于匹配固件几何参数、舵机 ID 和零位的机械臂；不是任意机械臂通用接口。数组顺序为四个关节/坐标分量。 |
| 147 | 机械臂手动标定模式 | `{"T":147}` | 仅用于匹配固件几何参数、舵机 ID 和零位的机械臂；不是任意机械臂通用接口。数组顺序为四个关节/坐标分量。 |

## 外接模块

| T | 功能 | 发送 JSON | 参数说明 |
| --- | --- | --- | --- |
| 200 | 兼容 LED 单灯颜色 | `{"T":200,"id":40,"set":[1,255,0,0]}` | 按示例字段设置参数；执行前确认目标设备和供电。 |
| 201 | 兼容 LED 全部颜色 | `{"T":201,"id":40,"set":[9,0,0]}` | 按示例字段设置参数；执行前确认目标设备和供电。 |
| 202 | OLED 单行文字 | `{"T":202,"line":1,"text":"Hello, world!","update":1}` | 需要外接 UI Module (A) 的 SSD1306 OLED；line 为 1–4，update=1 立即刷新。默认字体使用 ASCII。 |
| 203 | OLED 刷新 | `{"T":203}` | 需要外接 UI Module (A) 的 SSD1306 OLED；line 为 1–4，update=1 立即刷新。默认字体使用 ASCII。 |
| 204 | OLED 四行文字 | `{"T":204,"l1":"Hello, world!","l2":"Hello, world!","l3":"Hello, world!","l4":"Hello, world!"}` | 需要外接 UI Module (A) 的 SSD1306 OLED；line 为 1–4，update=1 立即刷新。默认字体使用 ASCII。 |
| 205 | OLED 清屏 | `{"T":205}` | 需要外接 UI Module (A) 的 SSD1306 OLED；line 为 1–4，update=1 立即刷新。默认字体使用 ASCII。 |
| 206 | 外接模块蜂鸣器 | `{"T":206,"freq":1000,"duration":1000}` | freq：Hz；duration：毫秒。蜂鸣器位于外接 UI Module (A)，GPIO21。 |
| 208 | 兼容 Node 修改 ID | `{"T":208,"old":0,"new":1}` | 保留的旧 Node 接口；新程序建议使用 T=710…713 的参数校验和结构化反馈。 |
| 209 | 兼容 Node PWM | `{"T":209,"id":0,"ch":0,"pwm":1000}` | 保留的旧 Node 接口；新程序建议使用 T=710…713 的参数校验和结构化反馈。 |
| 210 | 兼容 Node 单灯颜色 | `{"T":210,"id":0,"ch":0,"r":7,"g":7,"b":7}` | 保留的旧 Node 接口；新程序建议使用 T=710…713 的参数校验和结构化反馈。 |
| 211 | 兼容 Node 刷新 | `{"T":211,"id":0,"num":2}` | 保留的旧 Node 接口；新程序建议使用 T=710…713 的参数校验和结构化反馈。 |
| 212 | 兼容 Node 全灯颜色 | `{"T":212,"id":0,"num":2,"r":7,"g":7,"b":7}` | 保留的旧 Node 接口；新程序建议使用 T=710…713 的参数校验和结构化反馈。 |

## 任务脚本

| T | 功能 | 发送 JSON | 参数说明 |
| --- | --- | --- | --- |
| 300 | 列出任务 | `{"T":300}` | offset 默认为 0；每页 16 个名称，next=-1 表示结束；包含未完成草稿。 |
| 301 | 创建任务 | `{"T":301,"name":"demo","intro":"introduction for this mission file."}` | name：1–32 位英文字母、数字、下划线或连字符；intro 最多 96 UTF-8 字节；不能覆盖已有任务。 |
| 302 | 读取任务 | `{"T":302,"name":"demo"}` | offset 为从 0 开始的步骤偏移；每页最多 8 步，返回 intro/steps/total/next。 |
| 303 | 追加任务步骤 | `{"T":303,"name":"demo","json":"{\"T\":51,\"delay\":500}"}` | json 为转义后的 JSON 字符串；最多 64 步、文件最多 16 KB；步骤不能含 rid 或 T=300…399。 |
| 304 | 插入任务步骤 | `{"T":304,"name":"demo","step":1,"json":"{\"T\":51,\"delay\":500}"}` | step 从 1 开始，插入到指定步骤之前；json 为转义后的 JSON 字符串。 |
| 305 | 替换任务步骤 | `{"T":305,"name":"demo","step":1,"json":"{\"T\":51,\"delay\":500}"}` | step 从 1 开始，替换现有步骤；json 为转义后的 JSON 字符串。 |
| 306 | 删除任务步骤 | `{"T":306,"name":"demo","step":1}` | step 从 1 开始，删除指定步骤。 |
| 307 | 执行一个任务步骤 | `{"T":307,"name":"demo","step":1}` | step 从 1 开始；执行已保存的单步，可能产生运动。 |
| 308 | 运行任务 | `{"T":308,"name":"demo","interval":1000,"loop":1}` | interval 为每步后额外等待的毫秒数，0–60000；loop 为 1–10000 或 -1 无限循环。用 T=0 退出循环。 |
| 309 | 删除任务 | `{"T":309,"name":"demo"}` | 删除已保存任务，无法撤销。 |
| 310 | 保存已验证的草稿 | `{"T":310,"source":"draft_upload","name":"demo","overwrite":false}` | source 必须以 draft_ 开头；name 为目标名称。覆盖已有目标必须显式传 overwrite:true。 |

## 总线设备

| T | 功能 | 发送 JSON | 参数说明 |
| --- | --- | --- | --- |
| 700 | 扫描总线 ID | `{"T":700,"first":0,"last":20}` | 按示例字段设置参数；执行前确认目标设备和供电。 |
| 710 | TTL Node 修改 ID | `{"T":710,"id":1,"new_id":2}` | 按示例字段设置参数；执行前确认目标设备和供电。 |
| 711 | TTL Node PWM | `{"T":711,"id":1,"ch":1,"pwm":0}` | 按示例字段设置参数；执行前确认目标设备和供电。 |
| 712 | TTL Node RGB | `{"T":712,"id":1,"ch":0,"r":1,"g":0,"b":0}` | 按示例字段设置参数；执行前确认目标设备和供电。 |
| 713 | TTL Node 读取 S.BUS | `{"T":713,"id":1}` | 按示例字段设置参数；执行前确认目标设备和供电。 |
| 720 | 步进驱动 / 编码器修改 ID | `{"T":720,"id":1,"new_id":2}` | id/new_id 为不同的 0–253 整数；逐个接入设备，写入后验证新 ID。编码器与步进驱动共用此接口。 |
| 721 | 步进驱动模式 | `{"T":721,"id":1,"mode":0}` | mode=0 位置、1 连续转动、2 从动。mode=2 必须提供 leader_id（从 ID，0–253，与本机主 ID 不同），其值与被跟随设备 ID 相同。模式写入关闭输出；0/1 切换无需重启。 |
| 722 | 步进驱动位置基准 | `{"T":722,"id":1,"pos":0}` | 按示例字段设置参数；执行前确认目标设备和供电。 |
| 723 | 步进驱动反馈 | `{"T":723,"id":1}` | 按示例字段设置参数；执行前确认目标设备和供电。 |
| 724 | 步进驱动位置目标 | `{"T":724,"id":1,"pos":3200,"speed":100,"acc":10,"current":150}` | pos=0–65534，speed=1–32767，acc=0–254，current=0–1000。原始寄存器单位，current 不是安培。需先设位置模式并使能。 |
| 725 | 步进驱动连续速度 | `{"T":725,"id":1,"speed":0,"acc":10,"current":150}` | speed=-32767–32767，0 停止；acc=0–254，current=0–1000。先设连续模式并使能。 |
| 726 | 步进驱动输出开关 | `{"T":726,"id":1,"enable":0}` | enable=0 失能，1 使能。 |
| 730 | 编码器位置基准 | `{"T":730,"id":1,"pos":0}` | pos=0–65534；当前位置基准写入设备，不产生运动。 |
| 732 | 编码器位置与速度 | `{"T":732,"id":1}` | 返回 pos/speed；每圈 4096 计数，多圈位置 0–65534，掉电不保留累计圈数。 |

## 板载惯性传感器

| T | 功能 | 发送 JSON | 参数说明 |
| --- | --- | --- | --- |
| 740 | 读取板载惯性传感器 | `{"T":740}` | 按示例字段设置参数；执行前确认目标设备和供电。 |
