LygionOrganization/lygion-wiki/docs/reference/bus-devices/ttl-stepper-driver-a/memory-map.md

# TTL Stepper Driver (A) 内存表与相位计算

本页整理 TTL Stepper Driver (A) 的常用内存地址、特殊功能字节，以及用于计算 `驱动器相位` 的网页工具。

TTL Stepper Driver (A) 使用 FT-SCS 自定义协议。出厂默认串口参数为：

```text
波特率：1 Mbps
数据位：8
校验位：无
停止位：1
默认 ID：1
```

如果某个地址的数据长度为 2 字节，低位字节在前，高位字节在后，也就是小端格式。

!!! warning "谨慎修改 EPROM 参数"
    EPROM 地址中的 ID、波特率、运行模式、相位等参数会影响设备通信和底层行为。修改前建议记录原值；如果通过程序写入，需要确认写入锁和掉电保存逻辑。

## 相位快速计算

`驱动器相位` 位于地址 `18 / 0x12`，长度为 1 字节。下面的工具会根据各 bit 选项自动计算十进制写入值，也可以输入已有十进制值反向解析。

<div class="ttlsd-phase-tool" data-ttlsd-phase-tool>
  <div class="ttlsd-phase-grid">
    <div class="ttlsd-phase-panel">
      <h3>计算写入值</h3>
      <label>
        <span>驱动方向相位 BIT0</span>
        <select data-phase-bit="0">
          <option value="0">0：正向</option>
          <option value="1">1：反向</option>
        </select>
      </label>
      <label>
        <span>步数 M2M1M0 BIT3~BIT1</span>
        <select data-phase-microstep>
          <option value="0">000：15 rpm</option>
          <option value="2">001：7.5 rpm</option>
          <option value="4">010：未定义 / 保留</option>
          <option value="6">011：3.75 rpm</option>
          <option value="8">100：0.94 rpm</option>
          <option value="10">101：0.47 rpm</option>
          <option value="12">110：未定义 / 保留</option>
          <option value="14">111：未定义 / 保留</option>
        </select>
      </label>
      <label>
        <span>速度模式 BIT4</span>
        <select data-phase-bit="4">
          <option value="0">0：速度 0 表示停止</option>
          <option value="1">1：速度 0 表示最高速度</option>
        </select>
      </label>
      <label>
        <span>限位 / 零点相位 BIT5</span>
        <select data-phase-bit="5">
          <option value="0">0：0 电平有效</option>
          <option value="1">1：1 电平有效</option>
        </select>
      </label>
      <label>
        <span>目标电流相位 BIT6</span>
        <select data-phase-bit="6">
          <option value="0">0：目标电流 0 表示默认电流</option>
          <option value="1">1：目标电流 0 表示 0 电流</option>
        </select>
      </label>
      <label>
        <span>心跳功能 BIT7</span>
        <select data-phase-bit="7">
          <option value="0">0：关闭心跳</option>
          <option value="1">1：开启心跳</option>
        </select>
      </label>
    </div>

    <div class="ttlsd-phase-panel">
      <h3>结果</h3>
      <dl class="ttlsd-phase-result">
        <div>
          <dt>十进制</dt>
          <dd data-phase-dec>0</dd>
        </div>
      </dl>
      <label>
        <span>解析已有相位值</span>
        <input data-phase-input type="text" inputmode="numeric" placeholder="例如 161">
      </label>
      <p class="ttlsd-phase-hint" data-phase-message>输入 0~255 的十进制值，可反向解析。</p>
      <ul class="ttlsd-phase-breakdown" data-phase-breakdown></ul>
    </div>
  </div>
</div>

## 内存表分区

| 地址范围 | 分区 | 读写属性 | 用途 |
| --- | --- | --- | --- |
| `0x00~0x04` | 版本信息 | 只读 | 固件与驱动器版本 |
| `0x05~0x27` | EPROM 配置 | 读写 | ID、波特率、运行模式、相位、保护参数等 |
| `0x28~0x37` | SRAM 控制 | 读写 | 扭矩、加速度、目标位置、电流、速度等运行控制 |
| `0x38~0x43` | SRAM 反馈 | 只读 | 当前位置、当前速度、电压、温度、状态等反馈 |
| `0x53~0x56` | 出厂参数 | 只读 | 电流、速度、加速度限制与加速度倍数 |

## 版本信息

| 地址 DEC | 地址 HEX | 功能名称 | 字节数 | 初始值 | 权限 | 取值范围 | 单位 | 说明 |
| --- | --- | --- | --- | --- | --- | --- | --- | --- |
| 0 | `0x00` | 固件主版本号 | 1 | 8 | 只读 |  |  |  |
| 1 | `0x01` | 固件次版本号 | 1 | -- | 只读 | `0~39` |  |  |
| 2 | `0x02` | END | 1 | 0 | 只读 |  |  | `0` 表示小端存储结构 |
| 3 | `0x03` | 驱动器主版本号 | 1 | 10 | 只读 |  |  |  |
| 4 | `0x04` | 驱动器次版本号 | 1 | -- | 只读 |  |  |  |

## EPROM 配置

!!! note "地址列说明"
    下表的 HEX 地址按 DEC 地址统一换算；如果你手头的旧表格在 `35~38` 附近出现 DEC / HEX 不连续，以当前固件资料或实测读写结果为准。

| 地址 DEC | 地址 HEX | 功能名称 | 字节数 | 初始值 | 权限 | 取值范围 | 单位 | 说明 |
| --- | --- | --- | --- | --- | --- | --- | --- | --- |
| 5 | `0x05` | ID | 1 | 1 | 读写 | `0~253` | 号 | 总线上唯一的主 ID 标识 |
| 6 | `0x06` | 波特率 | 1 | 0 | 读写 | `0~7` | 无 | `0~7` 分别代表 `1000000`、`500000`、`250000`、`128000`、`115200`、`76800`、`57600`、`38400` |
| 7 | `0x07` | 从 ID | 1 | 0 | 读写 | `0~253` | 号 | 第二标识，只适用于写指令，用于从模式同步控制 |
| 8 | `0x08` | 应答状态级别 | 1 | 1 | 读写 | `0~1` | 无 | `0`：除读指令与 PING 外不返回应答包；`1`：所有指令返回应答包 |
| 9 | `0x09` | 最小角度限制 | 2 | 0 | 读写 | `0~65534` | 步 | 多圈绝对位置控制时此值为 `0` |
| 11 | `0x0B` | 最大角度限制 | 2 | 0 | 读写 | `0~65534` | 步 | 多圈绝对位置控制时此值为 `0` |
| 13 | `0x0D` | 最高温度上限 | 1 | 70 | 读写 | `0~100` | 摄氏度 |  |
| 14 | `0x0E` | 最高输入电压 | 1 | 250 | 读写 | `0~254` | 0.2 V | `250 x 0.2 = 50.0 V` |
| 15 | `0x0F` | 最低输入电压 | 1 | 40 | 读写 | `0~254` | 0.1 V |  |
| 16 | `0x10` | 无定义 | 1 | -- | 读写 | -- | -- |  |
| 17 | `0x11` | 无定义 | 1 | -- | 读写 | -- | -- |  |
| 18 | `0x12` | 驱动器相位 | 1 | -- | 读写 | `0~254` | 无 | 特殊功能字节，无特别需求不建议修改 |
| 19 | `0x13` | 卸载条件 | 1 | -- | 读写 | `0~254` | 无 | 对应 bit 为 `1` 开启相应保护，为 `0` 关闭 |
| 20 | `0x14` | 无定义 | 1 | -- | 读写 | -- | -- |  |
| 21 | `0x15` | 无定义 | 1 | -- | 读写 | -- | -- |  |
| 22 | `0x16` | 无定义 | 1 | -- | 读写 | -- | -- |  |
| 23 | `0x17` | 无定义 | 1 | -- | 读写 | -- | -- |  |
| 24 | `0x18` | 无定义 | 1 | -- | 读写 | -- | -- |  |
| 25 | `0x19` | 无定义 | 1 | -- | 读写 | -- | -- |  |
| 26 | `0x1A` | 无定义 | 1 | -- | 读写 | -- | -- |  |
| 27 | `0x1B` | 无定义 | 1 | -- | 读写 | -- | -- |  |
| 28 | `0x1C` | 默认电流 | 2 | -- | 读写 | `0~1000` | 1% | 上电后赋值给 `44 / 0x2C` 目标电流 |
| 30 | `0x1E` | 角度分辨率 | 1 | 1 | 读写 | `1~128` | 无 | 对传感器最小分辨角度的放大系数 |
| 31 | `0x1F` | 无定义 | 1 | -- | 读写 | -- | -- |  |
| 32 | `0x20` | 无定义 | 1 | -- | 读写 | -- | -- |  |
| 33 | `0x21` | 运行模式 | 1 | 0 | 读写 | `0~3` | 无 | `0`：位置伺服模式；`1`：电机恒速模式；`2`：从模式 |
| 34 | `0x22` | 保护电流 | 1 | -- | 读写 | `0~100` | 0.1% |  |
| 35 | `0x23` | 保护时间 | 1 | -- | 读写 | `0~254` | 10 ms |  |
| 36 | `0x24` | 无定义 | 1 | -- | 读写 | -- | -- |  |
| 37 | `0x25` | 无定义 | 1 | -- | 读写 | -- | -- |  |
| 38 | `0x26` | 心跳保护时间 | 1 | -- | 读写 | `0~254` | 100 ms |  |

## SRAM 控制

| 地址 DEC | 地址 HEX | 功能名称 | 字节数 | 初始值 | 权限 | 取值范围 | 单位 | 说明 |
| --- | --- | --- | --- | --- | --- | --- | --- | --- |
| 40 | `0x28` | 扭矩开关 | 1 | 0 | 读写 | `0~1` | 无 | 写 `0` 关闭扭力输出；写 `1` 打开扭力输出 |
| 41 | `0x29` | 加速度 | 1 | 0 | 读写 | `0~254` | 100 微步/秒² | 实际加速度 = 加速度 `(41)` x 加速度倍数 `(86)`；`0` 表示最大加速度 |
| 42 | `0x2A` | 目标位置 | 2 | 0 | 读写 | `0~65534` | 步 | 绝对位置控制；步单位 = 微步 x 角度分辨率 |
| 44 | `0x2C` | 目标电流 | 2 | 默认电流 `(28)` | 读写 | `0~1000` | 0.1% | `BIT10` 为方向位 |
| 46 | `0x2E` | 运行速度 | 2 | 出厂默认最大速度 | 读写 | `-32767~32767` | 50 微步/秒 | 控制最高运行速度；恒速模式下 `BIT15` 为速度方向位 |
| 48 | `0x30` | 无定义 | 1 | -- | 读写 | -- | -- |  |
| 49 | `0x31` | 无定义 | 1 | -- | 读写 | -- | -- |  |
| 50 | `0x32` | 无定义 | 1 | -- | 读写 | -- | -- |  |
| 51 | `0x33` | 无定义 | 1 | -- | 读写 | -- | -- |  |
| 52 | `0x34` | 无定义 | 1 | -- | 读写 | -- | -- |  |
| 53 | `0x35` | 无定义 | 1 | -- | 读写 | -- | -- |  |
| 54 | `0x36` | 无定义 | 1 | -- | 读写 | -- | -- |  |
| 55 | `0x37` | 锁标志 | 1 | 1 | 读写 | `0~1` | 无 | 写 `0` 关闭写入锁，写入 EPROM 地址的值掉电保存；写 `1` 打开写入锁，EPROM 写入掉电不保存 |

## SRAM 反馈

| 地址 DEC | 地址 HEX | 功能名称 | 字节数 | 初始值 | 权限 | 取值范围 | 单位 | 说明 |
| --- | --- | --- | --- | --- | --- | --- | --- | --- |
| 56 | `0x38` | 当前位置 | 2 | -- | 只读 | -- | 步 | 反馈电机当前绝对位置，步单位 = 微步 x 角度分辨率 |
| 58 | `0x3A` | 当前速度 | 2 | -- | 只读 | -- | 50 微步/秒 | `BIT15` 为方向位 |
| 60 | `0x3C` | 输出脉冲 | 2 | -- | 只读 | -- | 脉冲/毫秒 | 当前控制输出脉冲速率，`BIT10` 为方向位 |
| 62 | `0x3E` | 当前电压 | 1 | -- | 只读 | -- | 0.1 V | 当前驱动器工作电压 |
| 63 | `0x3F` | 当前温度 | 1 | -- | 只读 | -- | 摄氏度 | 当前驱动器内部工作温度 |
| 64 | `0x40` | 异步写标志 | 1 | 0 | 只读 | -- | 无 | 采用异步写指令时的标志位 |
| 65 | `0x41` | 驱动器状态 | 1 | 0 | 只读 | -- | 无 | 对应 bit 被置 `1` 表示相应错误出现 |
| 66 | `0x42` | 移动标志 | 1 | 0 | 只读 | -- | 无 | 运动时为 `1`，到达目标并停止时为 `0`；飞跳保持触发标志为 `2` |
| 67 | `0x43` | 目标位置 | 2 | -- | 只读 | -- | 步 | 当前目标位置 |

## 出厂参数

| 地址 DEC | 地址 HEX | 功能名称 | 字节数 | 初始值 | 权限 | 取值范围 | 单位 | 说明 |
| --- | --- | --- | --- | --- | --- | --- | --- | --- |
| 83 | `0x53` | 最大电流限制 `(x4)` | 1 | -- | 只读 | -- | -- | -- |
| 84 | `0x54` | 最大速度限制 | 1 | -- | 只读 | -- | -- | `x20` |
| 85 | `0x55` | 加速度限制 | 1 | -- | 只读 | -- | -- | -- |
| 86 | `0x56` | 加速度倍数 | 1 | -- | 只读 | -- | -- | -- |

## 特殊字节解释

### 驱动器相位 `0x12`

| bit | 权重 | 含义 | `0` | `1` |
| --- | --- | --- | --- | --- |
| BIT0 | 1 | 驱动方向相位 | 正向 | 反向 |
| BIT1 | 2 | 步数 M0 | 见 M2M1M0 编码 | 见 M2M1M0 编码 |
| BIT2 | 4 | 步数 M1 | 见 M2M1M0 编码 | 见 M2M1M0 编码 |
| BIT3 | 8 | 步数 M2 | 见 M2M1M0 编码 | 见 M2M1M0 编码 |
| BIT4 | 16 | 速度模式 | 速度 `0` 表示停止 | 速度 `0` 表示最高速度 |
| BIT5 | 32 | 限位 / 零点相位 | `0` 电平有效 | `1` 电平有效 |
| BIT6 | 64 | 目标电流相位 | 目标电流 `0` 表示默认电流 | 目标电流 `0` 表示 0 电流 |
| BIT7 | 128 | 心跳功能 | 关闭心跳功能 | 开启心跳功能 |

M2M1M0 编码：

| M2M1M0 | 相位值贡献 | 说明 |
| --- | --- | --- |
| `000` | `0` | 15 rpm |
| `001` | `2` | 7.5 rpm |
| `011` | `6` | 3.75 rpm |
| `100` | `8` | 0.94 rpm |
| `101` | `10` | 0.47 rpm |

### 驱动器状态 `0x41`

状态 bit 为 `0` 表示正常，`1` 表示异常。

| bit | 权重 | 含义 | 恢复条件 |
| --- | --- | --- | --- |
| BIT0 | 1 | 过压 / 欠压 | 电压恢复正常 |
| BIT1 | 2 | 目标超限 | 目标恢复正常 |
| BIT2 | 4 | 温度过热 | 温度恢复正常 |
| BIT3 | 8 | 过流触发，检测 FALT 低电平 | 打开扭矩开关恢复 |
| BIT4 | 16 | 自动限流 | 更新目标恢复 |
| BIT5 | 32 | 限位触发 | 限位开关联动和去抖后恢复 |
| BIT6 | 64 | 目标超限 | 目标恢复正常 |
| BIT7 | 128 | 零点触发 | 零点开关联动和去抖后恢复 |

### 卸载条件 `0x13`

卸载条件 bit 为 `0` 表示关闭，`1` 表示开启。

| bit | 权重 | 含义 |
| --- | --- | --- |
| BIT0 | 1 | 电压保护：关闭扭矩开关，电压恢复后自动恢复 |
| BIT1 | 2 | 保留 |
| BIT2 | 4 | 过热保护：关闭扭矩开关，温度恢复后自动恢复 |
| BIT3 | 8 | 保留 |
| BIT4 | 16 | 限流保护：无目标更新且电机停止运行时，自动降低输出电流至保护值 |
| BIT5 | 32 | 保留 |
| BIT6 | 64 | 限位保护：减速停止，反向远离后恢复 |
| BIT7 | 128 | 保留 |
