LygionOrganization/lygion-wiki/docs/reference/bus-devices/robocore-s3/assets/board-front.webp

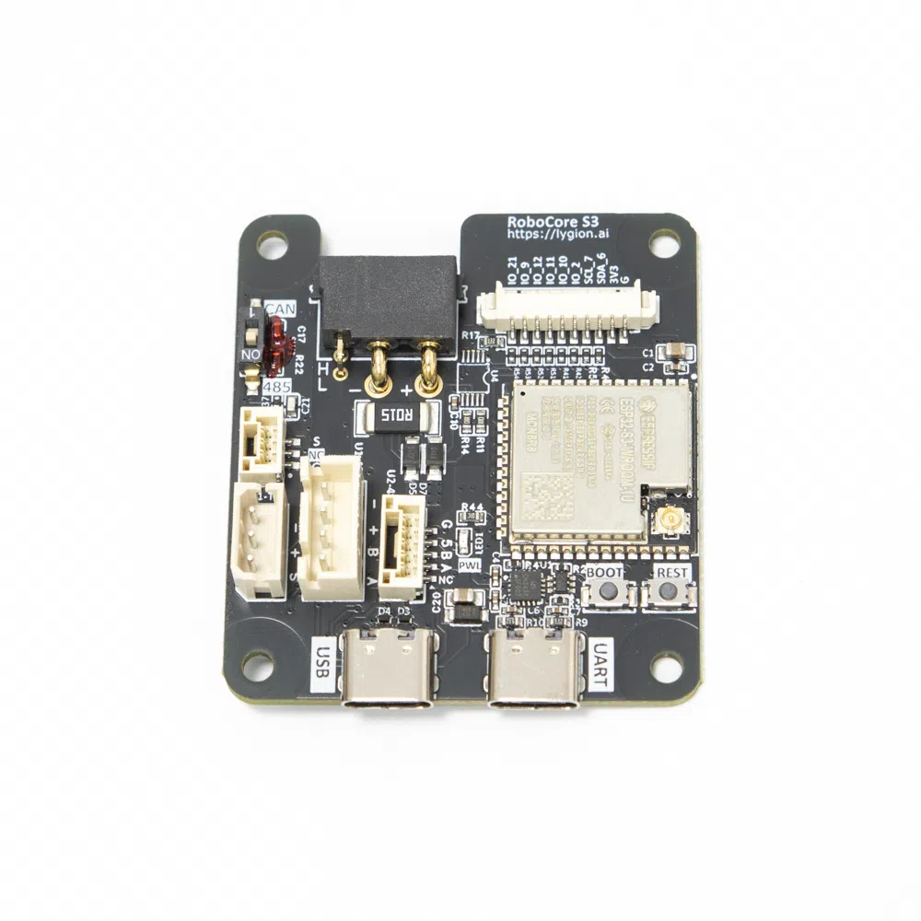
docs/reference/bus-devices/robocore-s3/assets/board-front.webp
