LygionOrganization/lygion-wiki/docs/reference/bus-devices/robocore-s3/assets/board-perspective.webp

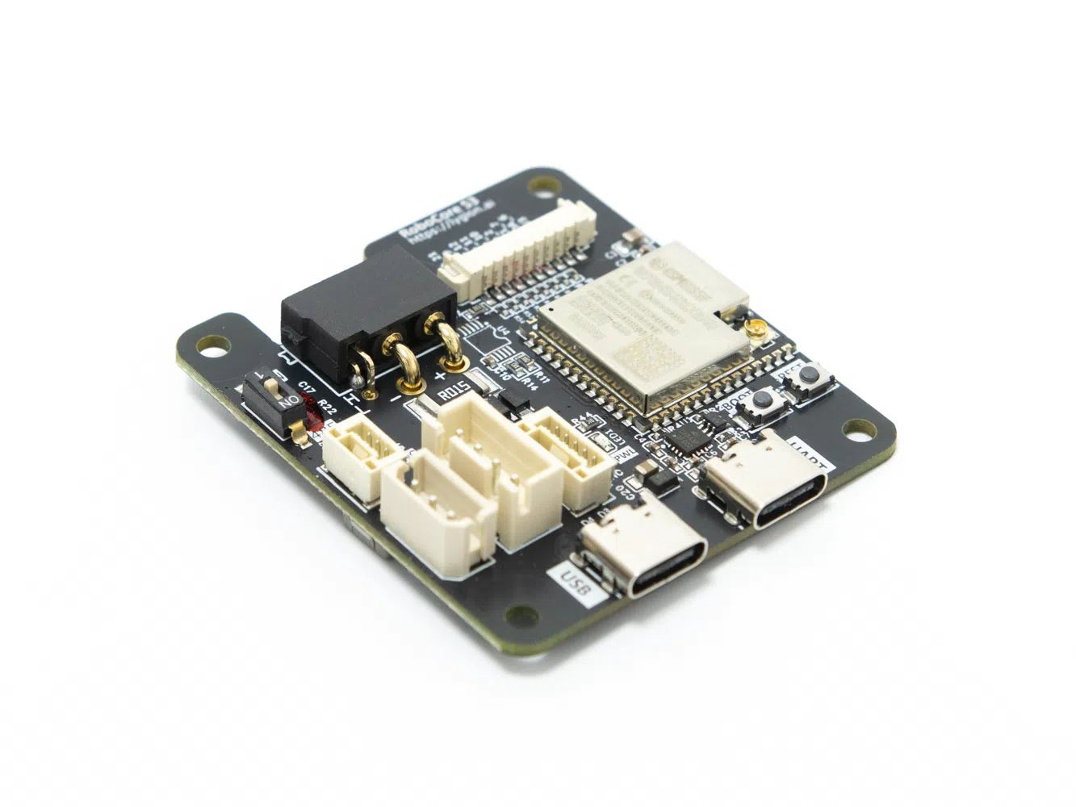
docs/reference/bus-devices/robocore-s3/assets/board-perspective.webp
