LygionOrganization/lygion-wiki/docs/reference/modules/dm42-g7220-e02/assets/fd-software-en.webp

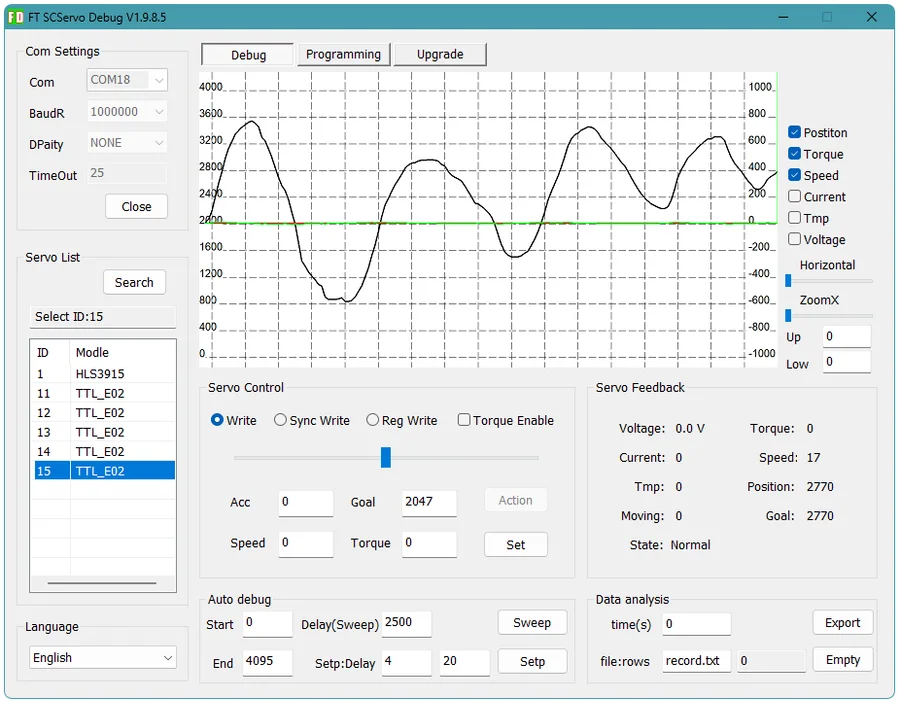
docs/reference/modules/dm42-g7220-e02/assets/fd-software-en.webp
