LygionOrganization/lygion-wiki/docs/reference/bus-devices/bus-servos/assets/arms-0090/tenarm.stp

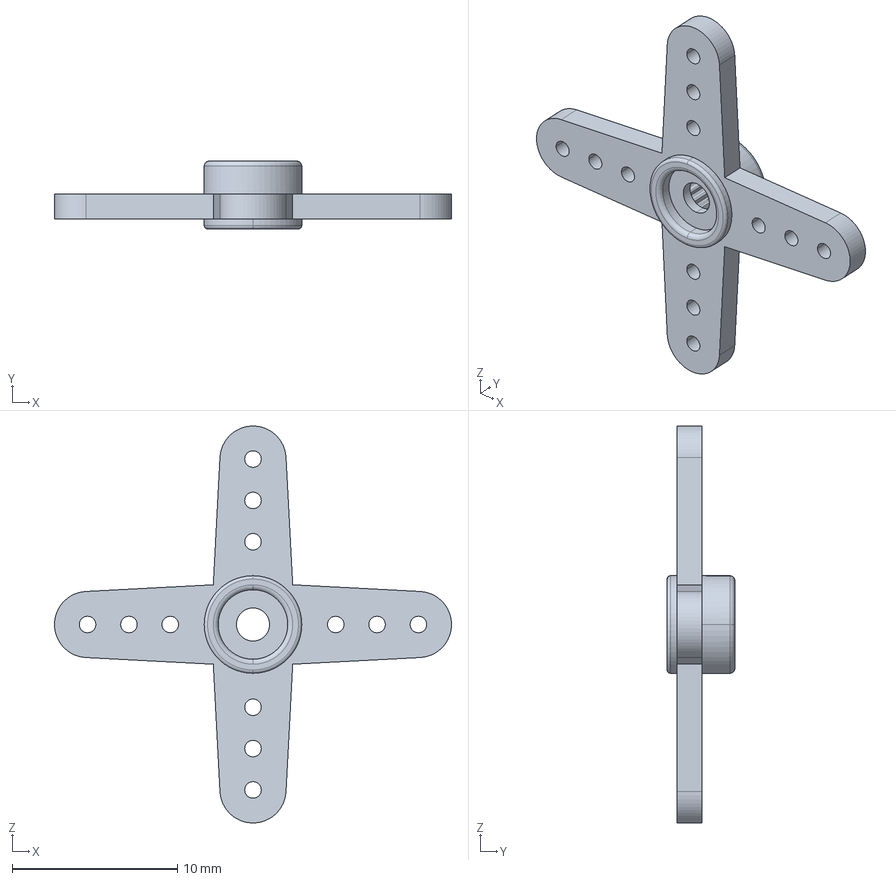
[picture p110: CAD file, 2026-06-16]
docs/reference/bus-devices/bus-servos/assets/arms-0090/tenarm.stp
24.0 x 4.10 x 24.0 mm
