LygionOrganization/lygion-wiki/docs/reference/bus-devices/bus-servos/assets/SC-1500-C024.stp

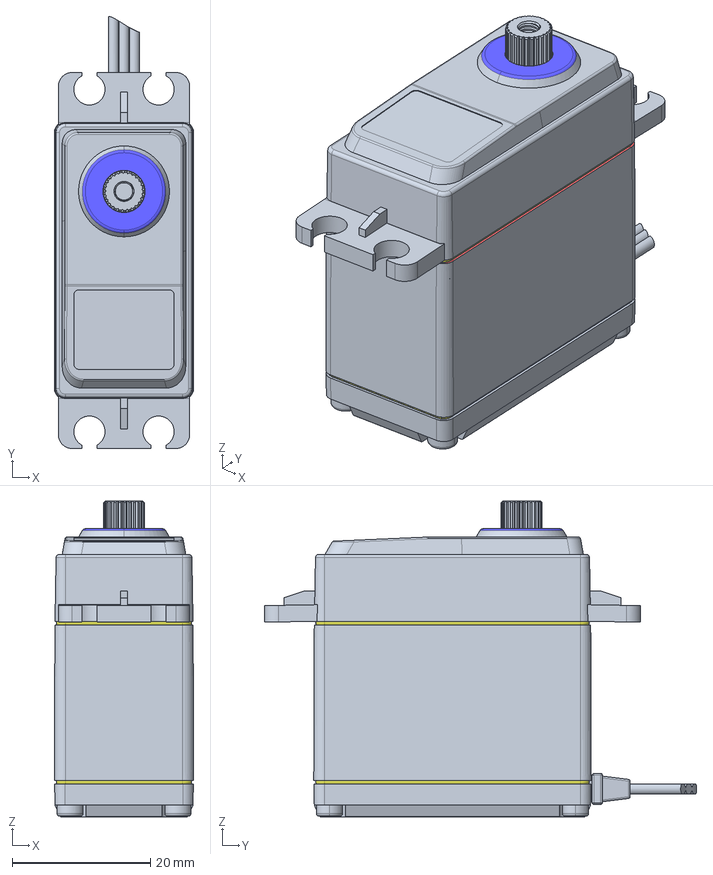
[picture p111: CAD file, 2026-06-16]
docs/reference/bus-devices/bus-servos/assets/SC-1500-C024.stp
20.2 x 62.5 x 45.7 mm
WJ-WK00-0191-PWM_37
SJ-WK00-0063-BOTTOMCASE_78
OUTPUTGEAR_12
CHOUCHENG_1 x 2
MANIFOLD_SOLID_BREP_43701
MANIFOLD_SOLID_BREP_43746
SJ-WK00-0060-TOPCABINET-LOW_54
XIANTAO_1_2
O-RING_3 x 2
SJ-WK00-0062-MIDDLECASE-PWM_79
M20X30_3 x 4
