LygionOrganization/lygion-wiki/docs/reference/bus-devices/robocore-s3/assets/RoboCore_S3.step

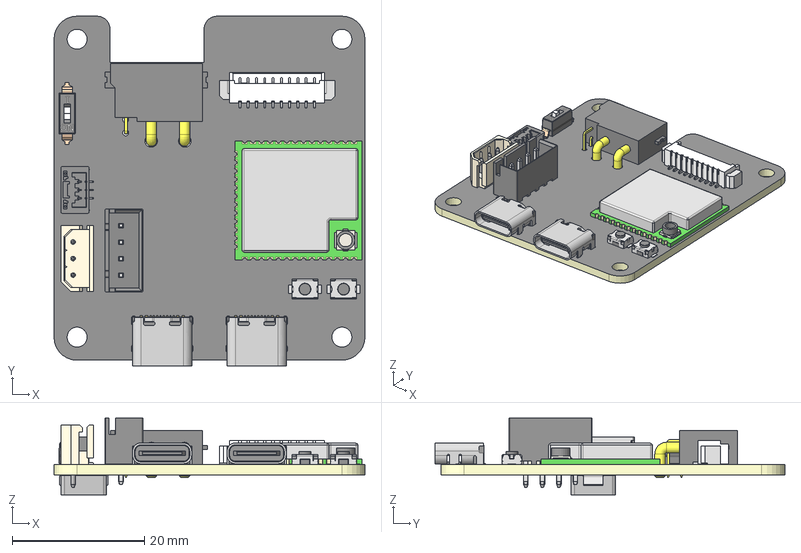
[picture p112: CAD file, 2026-10-21]
docs/reference/bus-devices/robocore-s3/assets/RoboCore_S3.step
47.0 x 52.8 x 11.6 mm
