LygionOrganization/lygion-wiki/docs/reference/bus-devices/robot-driver-with-esp32s3-lite/assets/Robot Driver with ESP32S3 Lite.step

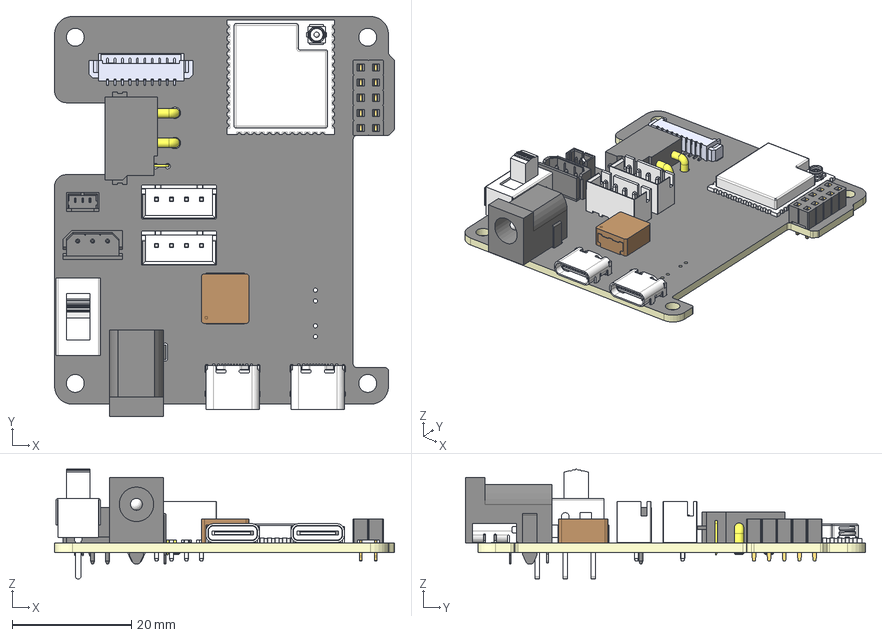
[picture p113: CAD file, 2026-06-16]
docs/reference/bus-devices/robot-driver-with-esp32s3-lite/assets/Robot Driver with ESP32S3 Lite.step
57.0 x 67.1 x 18.4 mm
CONN-TH_4P-XT30PW-M~CONN-TH_4P-XT30PW-M~qkbq
DC-IN-TH_G-SWITCH_DC-005H-D020~DC-IN-TH_G-SWITCH_DC-005H-D020~qkbq
IND-SMD_L8.5-W8.0_PCC-M0854M~IND-SMD_L8.5-W8.0_PCC-M0854M~qkbq
CONN-TH_4P-P2.50_4PIN~CONN-TH_4P-P2.50_4PIN~qkbq x 2
CONN-TH_3P-P1.25_HCTL_HC-1.25-3A~CONN-TH_3P-P1.25_HCTL_HC-1.25-3A~qkb q
SW-TH_SS-12D10L9~SW-TH_SS-12D10L9~qkbq
WIRELM-SMD_ESP32-S3-WROOM-1U~WIRELM-SMD_ESP32-S3-WROOM-1U~qkbq
USB-C-SMD_TYPE-C-6PIN-2MD-073~USB-C-SMD_TYPE-C-6PIN-2MD-073~qkbq x 2
CONN-SMD_10P-P1.25_XDWF-0125WT-10P~CONN-SMD_10P-P1.25_XDWF-0125WT-10P ~qkbq
CONN-TH_5264-3A_C2839661~CONN-TH_5264-3A_C2839661~qkbq
HDR-TH_10P-P2.54-V-F-R2-C5-S2.54~HDR2.54-F-LI-2X5P~qkbq
