LygionOrganization/lygion-wiki/docs/reference/bus-devices/ttl-adapter-a/assets/ttl-adapter-a.step

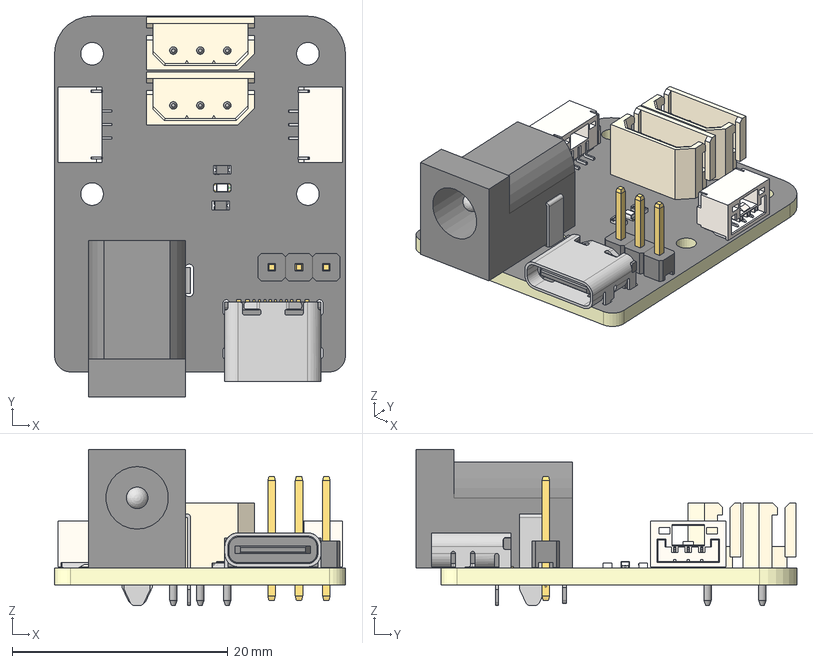
[picture p114: CAD file, 2026-05-28]
docs/reference/bus-devices/ttl-adapter-a/assets/ttl-adapter-a.step
27.0 x 35.3 x 14.5 mm
Board~hTBf
R0603~R0603~hTBf x 2
HDR-TH_3P-P2.54-V-M-1~HDR-M-2.54_1x3~hTBf
CONN-SMD_3P-P1.25_BX-GH1.25-3PWT~CONN-SMD_3P-P1.25_BX-GH1.25-3PWT~hTB f x 2
CONN-TH_5264-3A_C2839661~CONN-TH_5264-3A_C2839661~hTBf x 2
DC-IN-TH_G-SWITCH_DC-005H-D020~DC-IN-TH_G-SWITCH_DC-005H-D020~hTBf
USB-C-SMD_TYPE-C-6PIN-2MD-073~USB-C-SMD_TYPE-C-6PIN-2MD-073~hTBf
LED-SMD_4P-L1.6-W0.8-TL-RD-1~LED-SMD_4P-L1.6-W0.8-H0.6-TR-RD~hTBf
