LygionOrganization/lygion-wiki/docs/reference/bus-devices/ttl-encoder-e02/assets/TTL-Encoder-E02.step

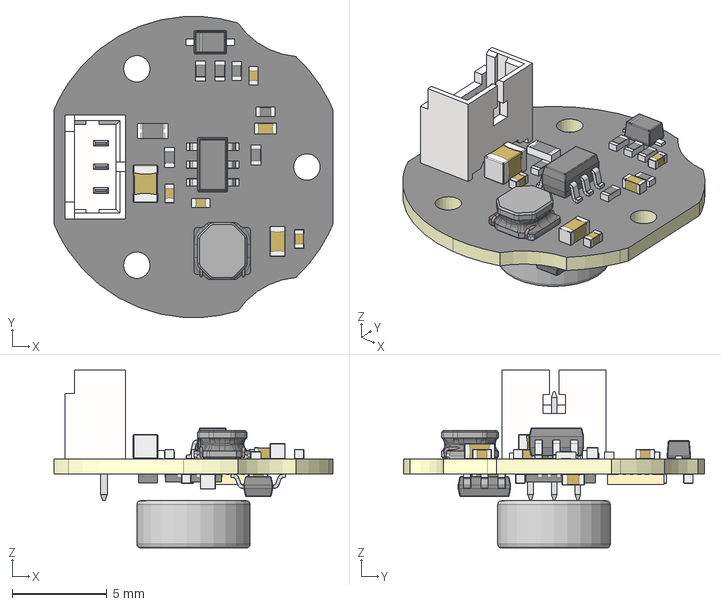
[picture p115: CAD file, 2026-05-30]
docs/reference/bus-devices/ttl-encoder-e02/assets/TTL-Encoder-E02.step
14.7 x 15.9 x 9.42 mm
