LygionOrganization/lygion-wiki/docs/reference/modules/4240by-g5-2/assets/4240BY-G5.2.step

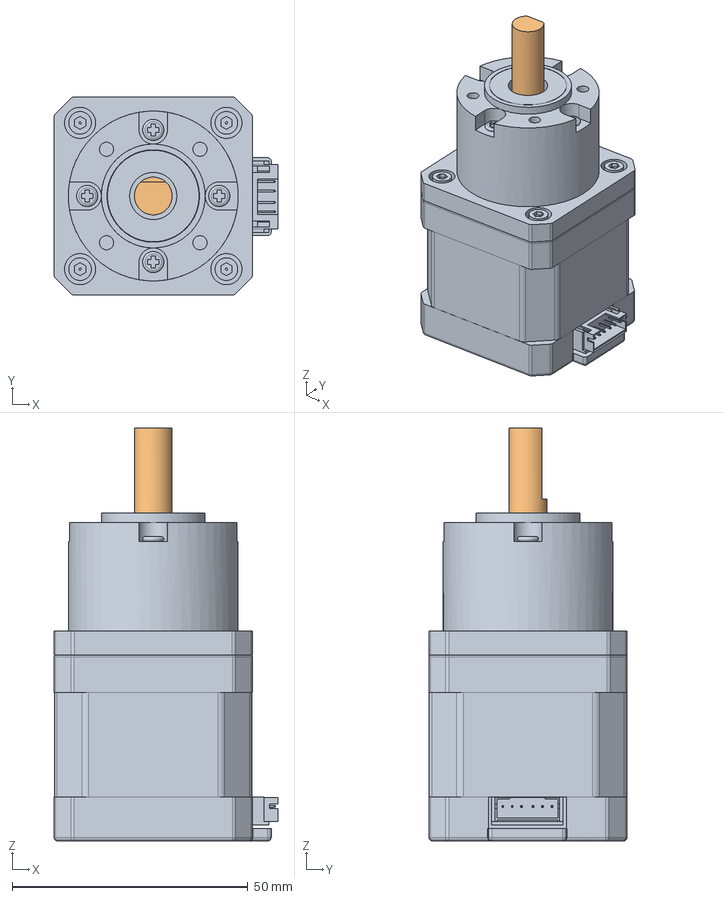
[picture p116: CAD file, 2026-07-07]
docs/reference/modules/4240by-g5-2/assets/4240BY-G5.2.step
47.4 x 42.0 x 87.5 mm
