LygionOrganization/lygion-wiki/docs/reference/modules/dm42-g7220-e02/assets/DM42-G7220-E02.dxf

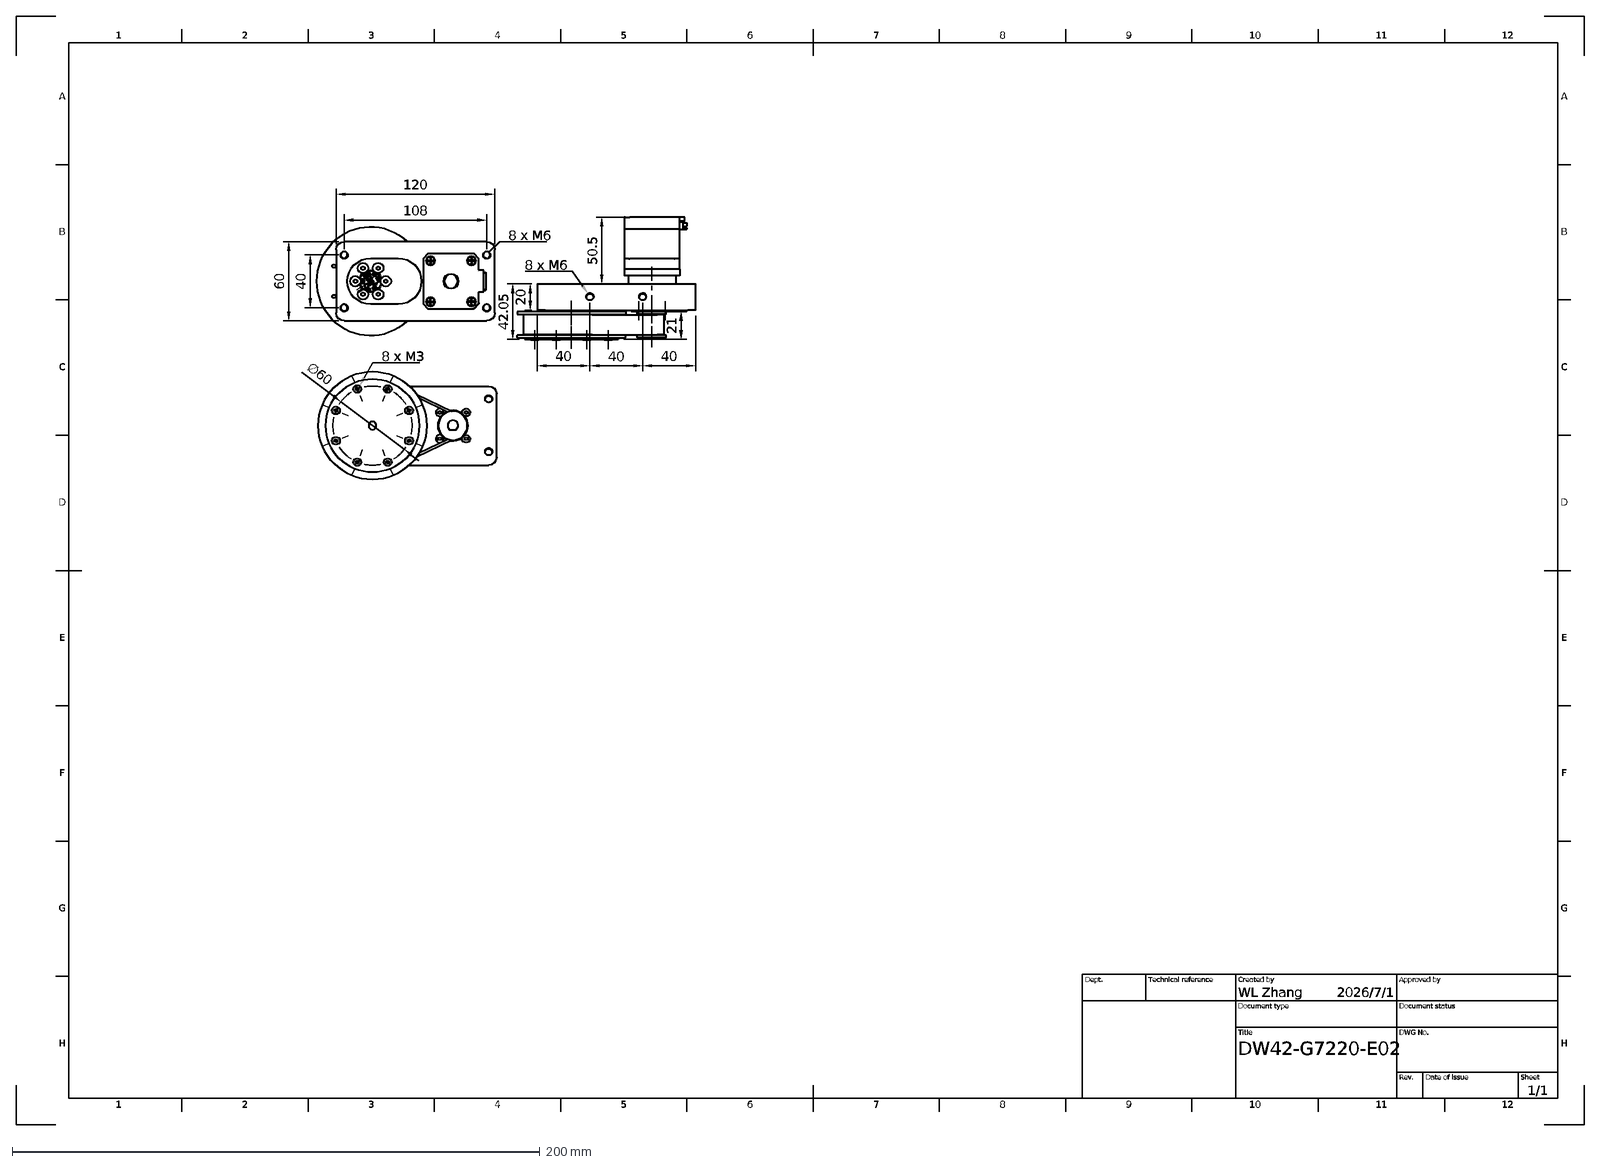
[picture p117: CAD file, 2026-07-09]
docs/reference/modules/dm42-g7220-e02/assets/DM42-G7220-E02.dxf
2
1
3
4
5
6
7
8
9
10
11
12
B
A
C
D
E
F
G
H
2026/7/1
1/1
DW42-G7220-E02
WL Zhang
Dept.
Technical reference
Created by
Approved by
Document type
Document status
Title
DWG No.
Rev.
Date of issue
Sheet
120
108
40
60
∅60
8 x M3
8 x M6
21
50.5
20
42.05
