LygionOrganization/lygion-wiki/docs/reference/modules/dw69/assets/DW69 [SP02][SP03].step

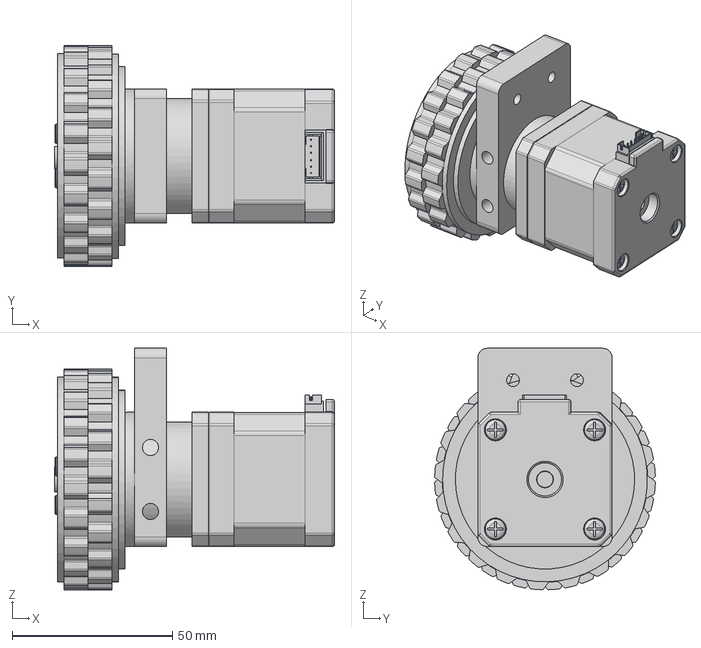
[picture p118: CAD file, 2026-07-07]
docs/reference/modules/dw69/assets/DW69 [SP02][SP03].step
87.5 x 69.0 x 75.5 mm
