LygionOrganization/lygion-wiki/docs/reference/modules/pulley-3m-72t/assets/SP3M72-E02.step

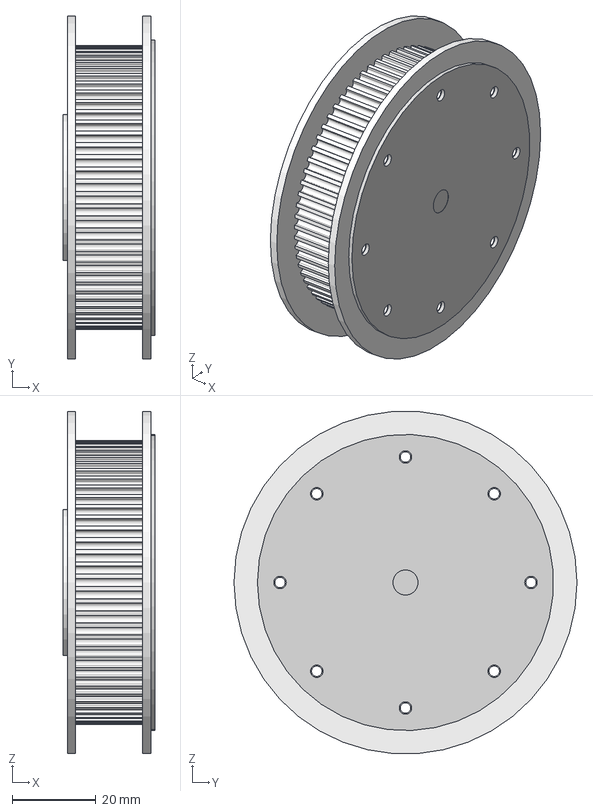
[picture p119: CAD file, 2026-07-07]
docs/reference/modules/pulley-3m-72t/assets/SP3M72-E02.step
22.1 x 82.0 x 81.8 mm
径向磁铁 6x2.5
零部件11
Board~WEAa
C0603~C0603_L1.6-W0.8-H0.8~Gsr1 x 2
C0402~C0603~Gsr1
C0402~C0402_L1.0-W0.5-H0.5~DAuZ x 8
C0402_2~C0402~DAuZ
SOD-323_L1.7-W1.3-LS2.6-RD~SOD-323_L1.7-W1.3-LS2.6-RD~LeN9
R0402~R0402_L1.0-W0.5-H0.4~bBGA x 4
R0402~R0402_L1.0-W0.5-H0.4~bBGA_1 x 2
C0805~C0805_L2.0-W1.3-H1.3~Qvh0
R0603_1~R0603~VFlx
DFN1006-2L-BI~DFN1006-2L-BI~H9ih
QFN-16_L3.0-W3.0-P0.50-TL-EP1.7~QFN-16_L3.0-W3.0-H0.9-P0.50~osxg
IND-SMD_L3.0-W3.0~IND-SMD_L3.0-W3.0-H1.5~XKTB
CONN-TH_3P-P1.25_HCTL_HC-1.25-3A~CONN-TH_3P-P1.25_HCTL_HC-1.25-3A~NvS u
QFN-20_L3.0-W3.0-P0.40-TL-EP1.7~QFN-20_L3.0-W3.0-H0.6-P0.40-BL~YPCA
SOT-23-5_L3.0-W1.7-P0.95-LS2.8-BR~SOT-23-5_L2.9-W1.6-H1.1-LS2.8-P0.95 ~l5Nq
SOT-23-6_L2.9-W1.6-P0.95-LS2.8-BL~SOT-23-6_L2.9-W1.6-H1.5-LS2.8-P0.95 ~Q2pL
