LygionOrganization/lygion-wiki/docs/reference/bus-devices/bus-servos/assets/arms-0090/cycle.stp

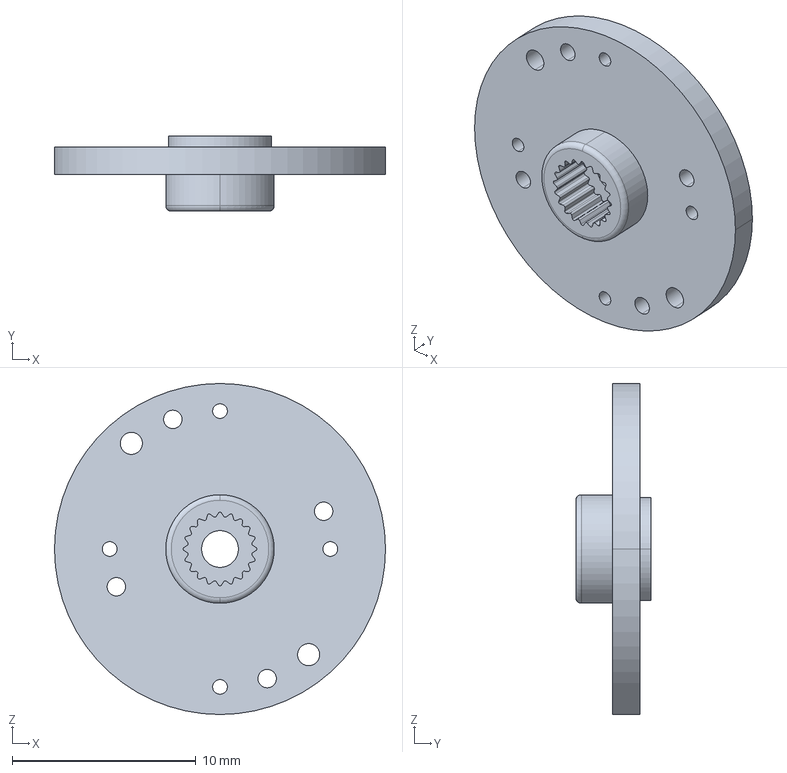
[picture p121: CAD file, 2026-06-16]
docs/reference/bus-devices/bus-servos/assets/arms-0090/cycle.stp
18.0 x 4.10 x 18.0 mm
