LygionOrganization/lygion-wiki/docs/reference/bus-devices/bus-servos/assets/SC-0090-C043.step

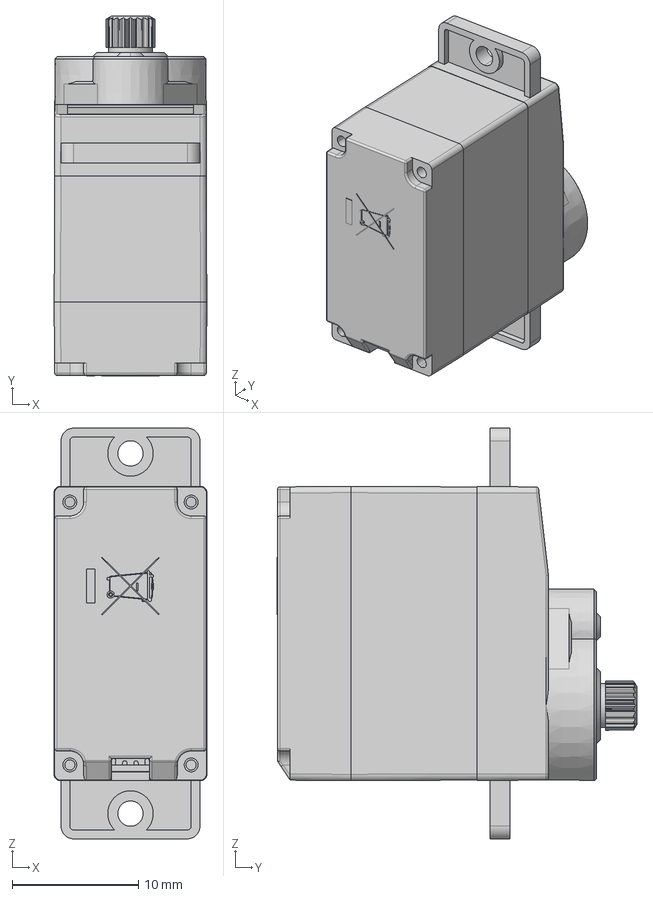
[picture p122: CAD file, 2026-06-16]
docs/reference/bus-devices/bus-servos/assets/SC-0090-C043.step
12.1 x 28.5 x 32.5 mm
SJ-WK00-0038-TOPCASE-0716_41_1
SJ-WK00-0039-COREMIDDLE-0716_65
SJ-WK00-0040-BOTTOMCASE-0716_12
SJ-CL00-0027-OUTPUTGEAR-0716_37
