LygionOrganization/lygion-wiki/docs/reference/modules/dw69/assets/DW69 [SP01].step

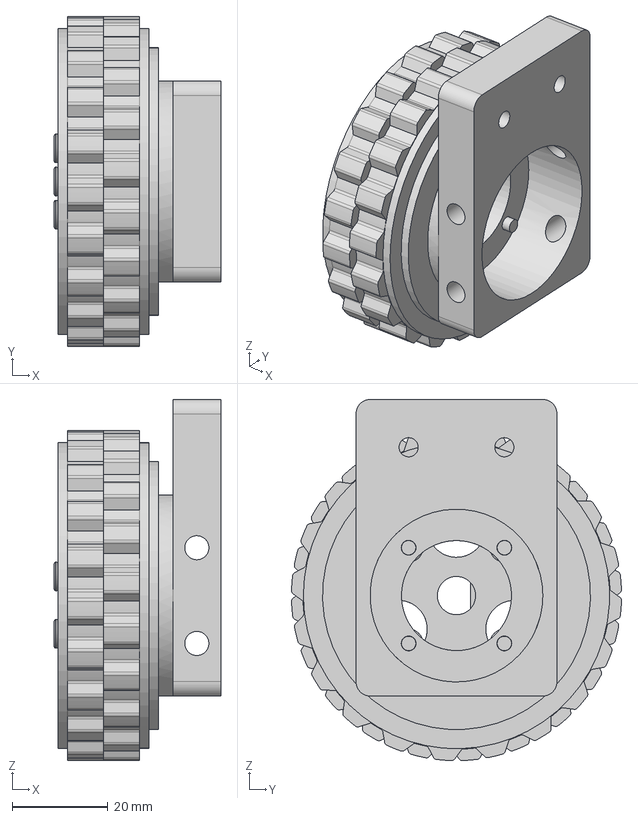
[picture p123: CAD file, 2026-07-07]
docs/reference/modules/dw69/assets/DW69 [SP01].step
34.8 x 69.0 x 75.5 mm
