LygionOrganization/lygion-wiki/docs/reference/modules/sw69-ttl/assets/SW69-TTL_STEP.step

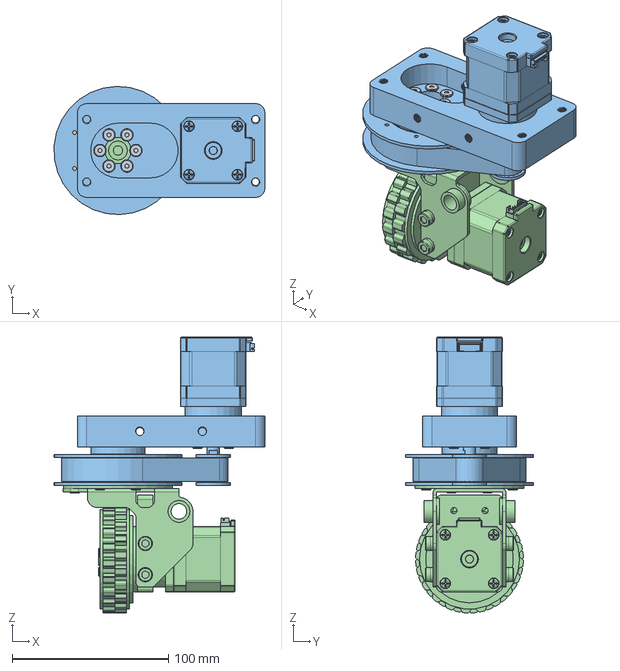
[picture p124: CAD file, 2026-07-07]
docs/reference/modules/sw69-ttl/assets/SW69-TTL_STEP.step
134.9 x 82.0 x 176.5 mm
黑色金属扁平头螺丝 CM4*8 x 9
CM3*8*6 x 12
