LygionOrganization/lygion-wiki/docs/reference/open-lygion/assets/OpenLygion Balance.step

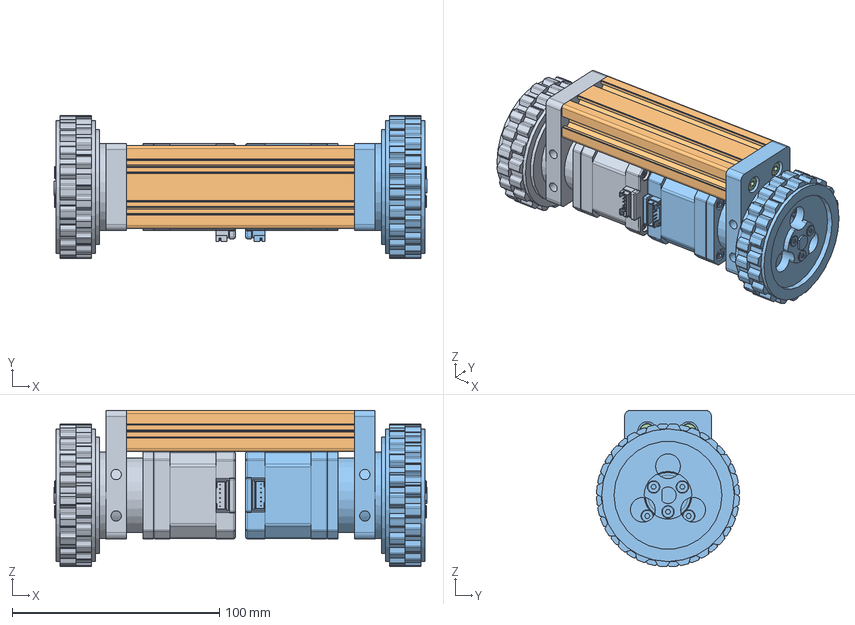
[picture p125: CAD file, 2026-07-07]
docs/reference/open-lygion/assets/OpenLygion Balance.step
180.0 x 69.0 x 75.5 mm
DW69 [SP02/3] v4
2040-110MM v1
DW69 [SP02/3] v4 (1)
M4*8 x 4
