LygionOrganization/lygion-wiki/docs/reference/bus-devices/bus-servos/assets/arms-0090/onearm.stp

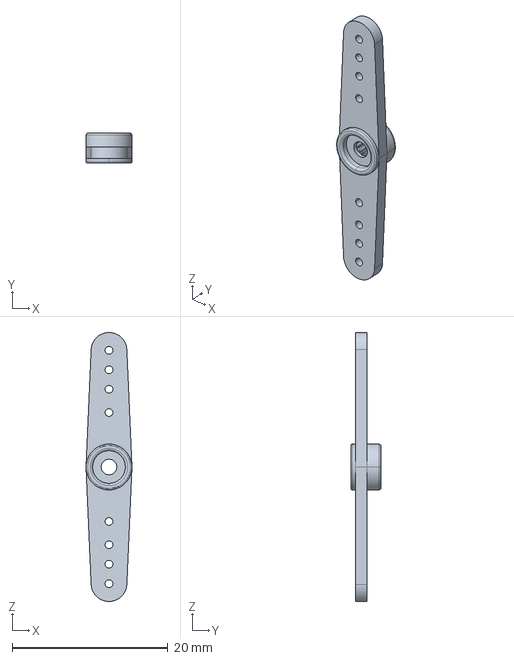
[picture p126: CAD file, 2026-06-16]
docs/reference/bus-devices/bus-servos/assets/arms-0090/onearm.stp
5.91 x 3.90 x 34.6 mm
