LygionOrganization/lygion-wiki/docs/reference/bus-devices/bus-servos/assets/SC-1500-C023.step

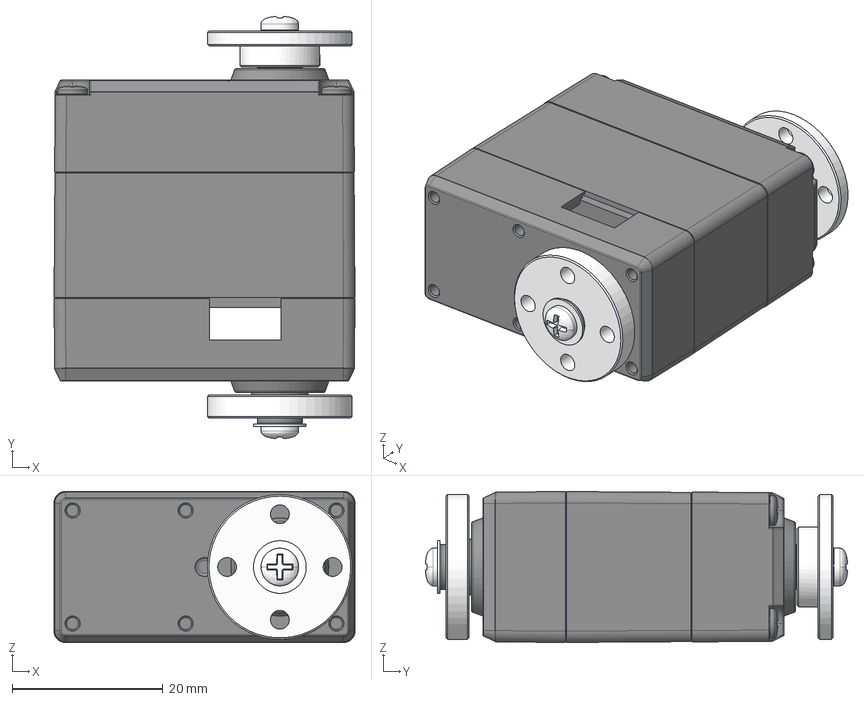
[picture p127: CAD file, 2026-06-16]
docs/reference/bus-devices/bus-servos/assets/SC-1500-C023.step
39.9 x 56.0 x 20.0 mm
MSBR-12
MSBR-11
MSBR-10
MSBR-9
MSBR-8
MSBR-7
MSBR-6
MSBR-5
MSBR-4
MSBR-3
MSBR-2
MSBR-1
