LygionOrganization/lygion-wiki/docs/reference/modules/dw69/assets/DW69.dxf

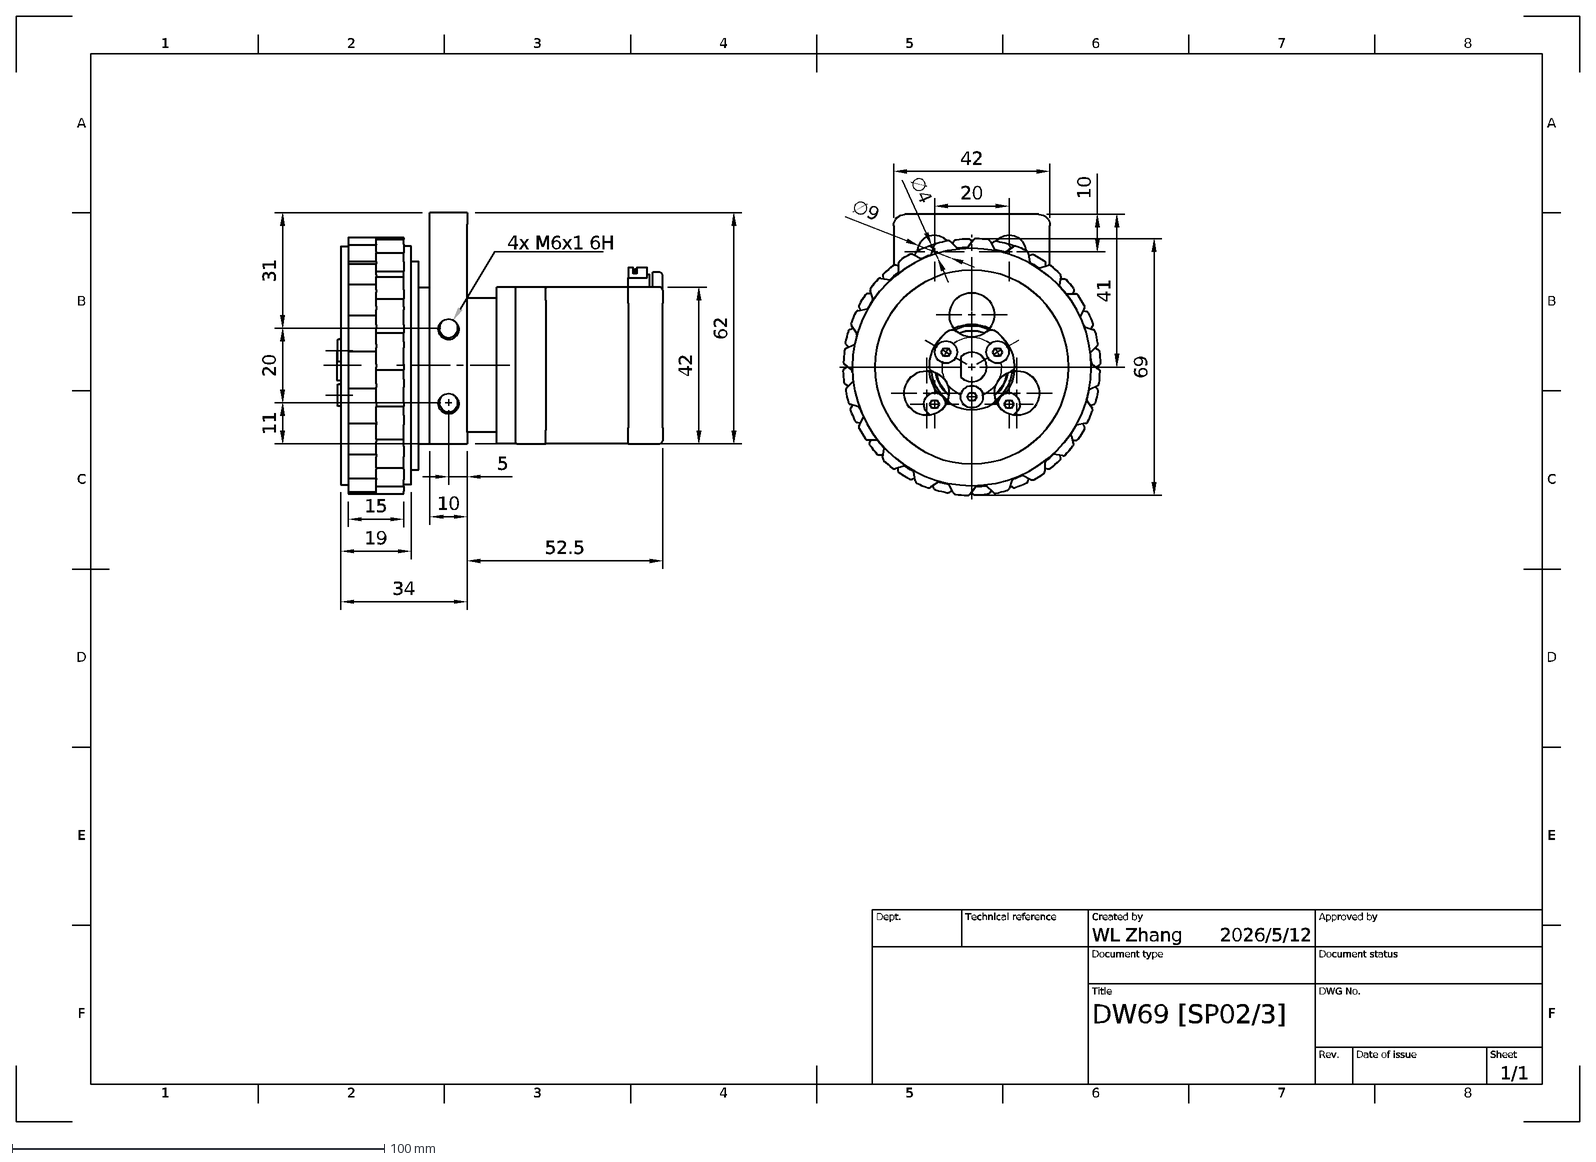
[picture p128: CAD file, 2026-07-07]
docs/reference/modules/dw69/assets/DW69.dxf
1
A
2
3
4
5
6
7
8
B
C
D
E
F
2026/5/12
1/1
DW69 [SP02/3]
WL Zhang
Dept.
Technical reference
Created by
Approved by
Document type
Document status
Title
DWG No.
Rev.
Date of issue
Sheet
4x M6x1 6H
15
19
34
10
52.5
42
62
20
11
31
∅4
∅9
69
41
