LygionOrganization/lygion-wiki/docs/reference/open-lygion/assets/OpenLygion 4WD AL.step

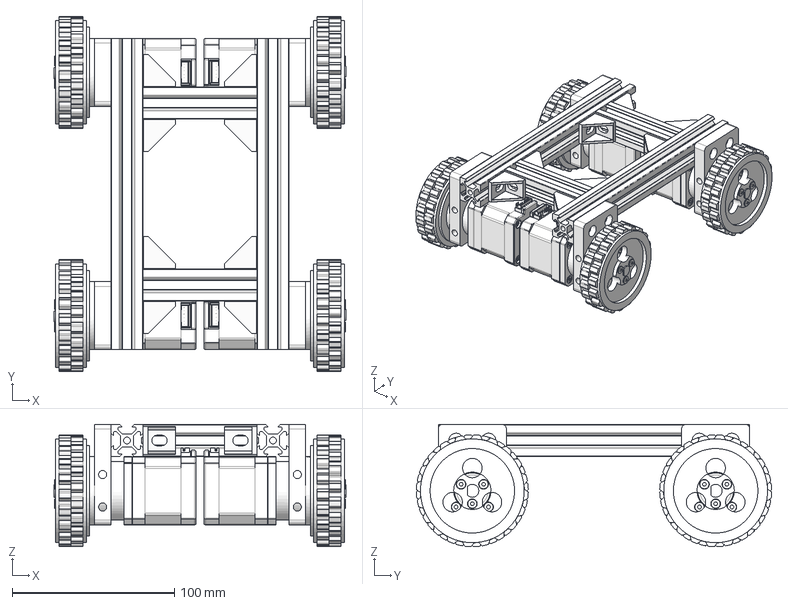
[picture p129: CAD file, 2026-07-07]
docs/reference/open-lygion/assets/OpenLygion 4WD AL.step
180.0 x 219.0 x 75.5 mm
DW69 [SP02/3] x 4
90 Degree Cast Corner for 2020 Extrusion (Ooznest) x 8
Profiles_2020V v1 x 2
Profiles_2020V v1 (1) x 2
