LygionOrganization/lygion-wiki/docs/reference/bus-devices/bus-servos/assets/arms-0090/haftarm.stp

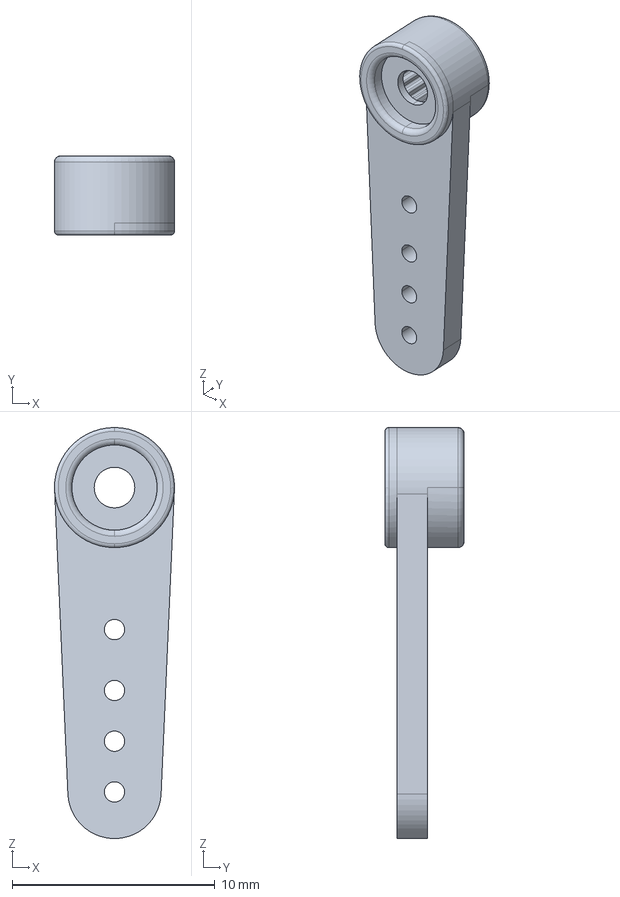
[picture p130: CAD file, 2026-06-16]
docs/reference/bus-devices/bus-servos/assets/arms-0090/haftarm.stp
5.92 x 3.90 x 20.3 mm
