LygionOrganization/lygion-wiki/docs/reference/open-lygion/assets/OpenLygion 4WD SheetMetal.step

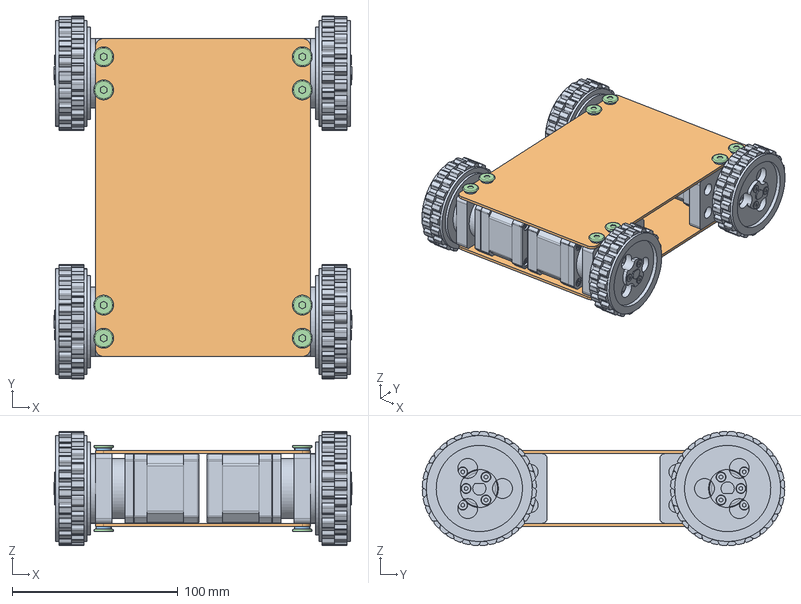
[picture p132: CAD file, 2026-07-07]
docs/reference/open-lygion/assets/OpenLygion 4WD SheetMetal.step
180.0 x 219.0 x 69.0 mm
DW69 [SP02/3] x 4
SheetMetal-A x 2
SP M6 v2 x 16
M6*6 x 16
