LygionOrganization/lygion-wiki/(list of files, cad)

Other CAD files:
docs/reference/modules/sw69-ttl/assets/SW69-TTL.dxf
docs/reference/robots/linkarm-lt/assets/LinkArm_LT_dxf.dxf
docs/reference/robots/linkarm-m/assets/LinkArm_LT_dxf.dxf
docs/reference/modules/4240by-g5-2/assets/4240BY-G5.2.dxf
docs/reference/modules/pulley-3m-72t/assets/SP3M72-E02.dxf
