LygionOrganization/lygion-wiki/docs/tutorials/index.md

# 基础教程

基础教程用于存放跨产品通用内容。产品页面中如果涉及这些基础操作，会直接链接到这里，避免每个产品文档重复讲解。

## 电脑和开发板（Python）

| 教程 | 适合用户 |
| --- | --- |
| [如何打开终端 / CMD / PowerShell](open-terminal.md) | 不知道在哪里输入命令的用户 |
| [安装 Python](install-python.md) | 第一次使用 Python 的用户 |
| [查找串口设备](find-serial-port.md) | 不知道 `COM3`、`/dev/ttyUSB0` 是什么的用户 |
| [运行 Python 脚本](run-python-scripts.md) | 不知道如何进入目录、创建虚拟环境、运行 `.py` 的用户 |

## 嵌入式设备（C++ / Arduino）

| 教程 | 适合用户 |
| --- | --- |
| [安装 Arduino IDE](install-arduino-ide.md) | 第一次使用 Arduino / ESP32 / STM32 示例的用户 |
| [安装 PlatformIO](install-platformio.md) | 使用 VS Code 做嵌入式开发的用户 |
| [VS Code + PlatformIO 复杂项目开发](platformio-development/index.md) | 修改完整固件、管理依赖和长期维护项目的用户 |
| [MCU UART 接线基础](mcu-uart-wiring.md) | 使用 ESP32 / STM32 / Arduino 连接 TTL 总线设备的用户 |
| [上传 Arduino 示例程序](upload-arduino-sketch.md) | 不熟悉 Arduino IDE 上传流程的用户 |
| [打开串口监视器](serial-monitor.md) | 不知道如何查看 MCU 输出的用户 |

## 总线设备基础

| 教程 | 适合用户 |
| --- | --- |
| [安装 USB 串口驱动](install-usb-serial-driver.md) | 电脑无法识别 TTL Adapter (A) 的用户 |
| [设备 ID 与波特率](device-id-and-baudrate.md) | 准备连接多个设备或修改参数的用户 |
| [供电与接线基础](power-and-wiring-basics.md) | 不确定电源、电压、总线线序的用户 |
| [常见通信问题排查](communication-troubleshooting.md) | 遇到读取失败、ping 失败、串口打不开的用户 |
| [FD 调试软件](fd-tool.md) | Windows 下使用图形化工具扫描、改 ID、调参的用户 |
