LygionOrganization/lygion-wiki/docs/en/tutorials/index.md

# Tutorials

These guides cover tasks that apply across multiple Lygion products. Product pages link here whenever a setup or troubleshooting step needs more explanation.

## Computers and SBCs

| Guide | Use it when |
| --- | --- |
| [Open a terminal, PowerShell, or Command Prompt](open-terminal.md) | You are not sure where to enter a command |
| [Install Python](install-python.md) | You are setting up Python for the first time |
| [Find the serial port](find-serial-port.md) | You need to identify `COM3`, `/dev/ttyUSB0`, or another port |
| [Run Python scripts](run-python-scripts.md) | You need help entering a directory, creating a virtual environment, or running an SDK example |

## Embedded Controllers

| Guide | Use it when |
| --- | --- |
| [Install Arduino IDE](install-arduino-ide.md) | You are new to Arduino, ESP32, or STM32 examples |
| [Install PlatformIO](install-platformio.md) | You use VS Code for embedded development |
| [MCU UART wiring](mcu-uart-wiring.md) | You need to connect an ESP32, STM32, or Arduino to the TTL bus |
| [Upload an Arduino example](upload-arduino-sketch.md) | You need help building and uploading an `.ino` sketch |
| [Use a serial monitor](serial-monitor.md) | You need to view MCU debug output |

## TTL Bus Fundamentals

| Guide | Use it when |
| --- | --- |
| [Install the USB serial driver](install-usb-serial-driver.md) | The computer does not recognize TTL Adapter (A) |
| [Device IDs and baud rates](device-id-and-baudrate.md) | You are adding devices or changing communication settings |
| [Power and wiring fundamentals](power-and-wiring-basics.md) | You need to verify voltage, power, or bus wire order |
| [Power grouping and isolation](power-grouping-and-decoupling.md) | Your system contains multiple voltages or high-current devices |
| [Communication troubleshooting](communication-troubleshooting.md) | A port will not open, a ping fails, or a read times out |
| [FD device utility](fd-tool.md) | You want to scan or configure devices from Windows |
For larger firmware projects, follow [Developing Complex Projects with VS Code and PlatformIO](platformio-development/index.md).
