LygionOrganization/lygion-wiki/(commit log)

2026-05-28 update ttl-adapter-a
    [ttl-adapter-a.step]
2026-05-30 update ttle02 and ttlsd
    [TTL-Encoder-E02.step]
2026-06-01 change wiki
    [TTL-Encoder-E02.step, ttl-adapter-a.step]
2026-06-01 update all
    [TTL-Encoder-E02.step, ttl-adapter-a.step]
2026-06-16 Refactor code structure for improved readability and maintainability
    [5-plus-1-dof-robotic-arm.step, LinkArm_LT_dxf.dxf, Robot Driver with ESP32S3 Lite.step, SC-0090-C043.step, SC-0090-C049.step, SC-1500-C023.step, SC-1500-C024.stp, cycle.stp]
2026-08-29 docs: add Open Lygion STEP resources
    [open_leader_arm.step]
